taoqiuyang/SailBoat/Project Website/images/Portfolio/Tao.jpg

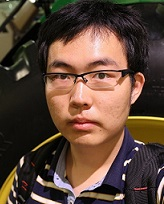
Project Website/images/Portfolio/Tao.jpg
