taoqiuyang/SailBoat/Project Website/images/Portfolio/Peng.jpg

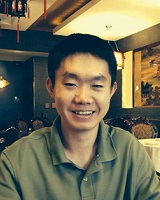
Project Website/images/Portfolio/Peng.jpg
