taoqiuyang/SailBoat/Document/Design/Requirements.docx

Requirements:

- Stay 30 days on ocean
- Autonomous control & navigation
- Multiple sensors

Two major parts:

- Energy harvest
- Control, navigation & actuation

Sensor and energy harvest options:

See Google Doc
