taoqiuyang/SailBoat/Document/Technical Review/Technical Review Xuefeng Jin.docx

Recharging Batteries for Autonomous Sailboat System

Introduction

Motivated mainly by latest energy sources such as the wave and the wind, autonomous sailboat system explores the viability of types of supply resource that are both economical and environmental-friendly. The electrical energy is the direct supply for motor and controller. Transforming other types of energy into electricity requires several storage elements that are highly efficient, environmental-friendly and lightweight. Chemical batteries, such as NiMH, Li-ion, and simple sea batteries, are the most appropriate choices for sailboat system. This technical review briefly summarizes some commercial and research battery choices for autonomous sailboat system, illustrates underlying technologies applied, and provides approaches of implementation for ideal operation.

Commercial and Research Choices of Batteries

The traditional Nickel-metal hydride (NiMH) and Lithium-ion (Li-ion) batteries are the most appropriate choices for the small sailboat system. Both of them are environmental-friendly and have no memory effect that refers to holding less charge after repeatedly recharging while being only partially discharged. They are perfect for storing energy supplied from the wind and the sun. Another type, broadly used in small projects for research, is the seawater battery that can store and transfer energy from seawater immediately. Therefore, it can be used to transform wave energy when the boat is moving.

NiMH Battery

Most small-sailboat teams used NiMH battery due to its simple implementation and low price [1-3]. It can be directly utilized through the connection, and has a voltage of 1.2 V, efficiency of 65-70%, typical specific energy of 60-120 Wh/kg, and a volumetric energy density of 140-200 Wh/L [4]. Panasonic “Eneloop” series battery can have a lifetime up to 2100 cycles [5]. The problem of high self-discharge was solved by Sanyo in 2005 with low self-discharge NiMH (LSD NiMH), and therefore it could be a competitor with Li-ion for boat system. Besides, the price has an advantage, typical 8-piece C-size NiMH rechargeable cell with 1.2 V and 5 Ah costs $30, while the 4-piece LiFePO4 with 3.6 V and 650 mAh costs $40 with protected circuit components [6-8].

Li-ion Battery

Li-ion battery is chosen due to stronger characteristics than those of NiMH. It has a voltage of 3.6-3.7 V, efficiency of 90-95%, specific energy of 100-265 Wh/kg, and higher energy density [9-11]. Among various types of Li-ion batteries, LiCoO2 has the highest energy density of more than 200 Wh/kg, and it is the most popular cell used in the market. However, it is unsafe without protection circuit (PC) and has a relatively low life cycles around 500. LiFePO4 is another type of Li-ion battery that has more than 2000 cycles of life, but it has relatively lower energy density of 120 Wh/kg [10]. The LiFePO4 cells are still in developing, and most of them are required to be industrial used only [12].

Seawater Battery

Some research teams have found seawater battery, which could draw electricity from seawater for free [13,14]. It is composed of magnesium as the anode, graphite as the cathode, and seawater as the electrolyte. The battery drives the output as long as it is in the sea. It has the simplest set-up, and provides constant propulsion for the boat. The cost is low for building one with basic connection. A one-foot magnesium anode with 0.5 inch diameter costs $4.03, and a one-foot graphite rod with 0.4 inch diameter costs $4 [15,16]. Thus, the seawater battery is the best approach for the sea-wave energy transformation.

Technology of basic batteries

Functionality

The basic recharging batteries transform the electrical to chemical energy during charging, and the process is reversed while discharging. During discharging, the positive active material is oxidized, while the negative material is reduced. Electrons constitute the current flow in external circuit, while the electrolyte serves as a bridge for ion-flow between electrodes. The process for both electrodes reverses while recharging.

Structure and Protection

In NiMH battery, the cathode is nickel oxyhydroxide (NiOOH), and the anode is a hydrogen-absorbing alloy such as TiZr and LaNi5 [17]. When the battery is overcharged at low rates, oxygen produced at the cathode recombines at the anode, suppressing hydrogen evolution and converting charging energy to heat. This process allows cells to remain sealed in normal operation. In Li-ion battery, the cathode is an intercalated lithium compound such as LiFePO4 or LiCoO2, and the anode is graphite for most cases. The electrolyte is a lithium salt in an organic solvent [18,19]. Since lithium is highly reactive with water, a non-aqueous electrolyte is applied. Therefore, it is significant to have an excellent sealed container that excludes moisture leaked by the battery for application in seawater. Particularly, the most concerned risk is that if over-charged, Li-ion battery will suffer thermal runaway and cell rupture that cause combustion, and therefore a protected circuit is required for disconnection when the voltage exceeds 3-4.2 V safety range [8,20]. The structure for seawater battery is the simplest. It is composed of magnesium alloy and graphite electrodes, while the electrolyte is the seawater.

Implementation

Due to the simplest setup and direct supply from seawater, seawater battery is an ideal choice for wave energy transformation. It can be directly connected to propeller for propulsion. The NiMH and LiFePO4 batteries are both ideal choices for transformation of other types of energy sources depend on the system requirements. NiMH battery can be directly utilized and can be over-charged at low rates. Li-ion battery requires a complex protected circuit board for safety consideration, which enhances the complexity of the design. The input of batteries is connected to the conditioning circuit that transforms renewable energy into stable electrical current and voltage. Typical conditioning circuit is composed of a converter, and its output should be applicable to battery other than super capacitor. The output goes to the motor and single-board computer that controls sensors for movements of the sailboat.

Reference

[1] SilverJimmy, “Making an autonomous boat using a Raspberry Pi (WiP),” Mar. 18, 2013. [Online].

Available: http://www.instructables.com/id/Making-an-autonomous-boat-with-a-Raspberry-Pi-a-/?

ALLSTEPS. [Accessed: Mar. 18, 2015].

[2] Aber’s Autonomous Sailing Robot, “Introducing the MaxiMOOP and our student Sailbot Team,” Jun.

08, 2013. [Online].

Available: https://microtransat.wordpress.com/. [Accessed: Mar. 18, 2015].

[3] Bluebird Marine Systems, “FishPi: An autonomous drop in the ocean.” [Online].

Available: http://www.bluebird-electric.net/artificial_intelligence_autonomous_robotics/

fishpi_raspberry_computer_autonomous_boat_marine_unmanned_surface_vessel_proof_of_

concept.htm. [Accessed: Mar. 18, 2015].

[4] PowerStream, “NiMH Battery Charging Basics,” Jan. 28, 2015. [Online]. Available:

http://www.powerstream.com/NiMH.htm. [Accessed: Mar. 18, 2015].

[5] Panasonic, “Eneloop series NiMH Products,” [Online]. Available:

http://panasonic.net/energy/battery/eneloop/lineup/. [Accessed: Mar. 18, 2015].

[6] AA Portable Power Corp, Pricing Information. Jun. 27, 2012. [Online]. Available:

http://www.batteryspace.com/csizeseriesbatteries.aspx.

[7] AA Portable Power Corp, Nickel-Metal Hydride Battery Specification Sheet. Jul. 7, 2009. [Online].

Available: http://www.batteryspace.com/prod-specs/MH-C5000_1.pdf.

[8] AA Portable Power Corp, “Category: PCB/PCM for 3.2 V LiFePO4 Pack (1S),” [Online].

Available: http://www.batteryspace.com/pcbfor32vlifepo4pack1inseries.aspx.

[Accessed: Mar. 20, 2015].

[9] Panasonic, Rechargeable Lithium-ion Battery CGR18650CG Specification Sheet. Dec. 2008.

[Online].

Available: http://web.archive.org/web/20100413182032/http://www.panasonic.com/industrial/

batteries-oem/oem/lithium-ion.aspx.

[10] AA Portable Power Corp, “Category: Li-Ion / Polymer Single Cells,” [Online].

Available: http://www.batteryspace.com/li-ionsinglecell.aspx. [Accessed: Mar. 20, 2015].

[11] C. Daniel, “Materials and Processing for Lithium-ion Battery,” JOM: Journal of the Minerals, Metals

and Materials Society, vol. 60, pp. 43-48, Sep. 2008.

[12] AA Portable Power Corp, “Category: CR123A Rechargeable LiFePO4/Li-ion Batteries,” [Online].

Available: http://www.batteryspace.com/rcr123aseries.aspx. [Accessed: Mar. 22, 2015].

[13] Free Electricity From Sea Water. [Video file]. Youtube, Nov. 7, 2014.

Available: https://www.youtube.com/watch?v=BsW3oQFdg6M&feature=youtu.be.

[Accessed: Mar. 20, 2015.].

[14] Electric Boat without Batteries. [Video file]. Youtube, Dec. 5, 2014.

Available: https://www.youtube.com/watch?v=U0OAaW4En7o&feature=youtu.be.

[Accessed: Mar. 20, 2015.].

[15] RotoMetals, Pricing Information. [Online]. Available:

http://www.rotometals.com/Magnesium-Anodes-s/22.htm. [Accessed: Mar. 22, 2015].

[16] Ebay, Pricing Information. [Online]. Available:

http://www.ebay.com/itm/5-pcs-99-99-Graphite-Electrode-Cylinder-Rod-Length-100mm-

Diameter-10mm-EV-28-/171398820297?pt=LH_DefaultDomain_0&hash=item27e82a71c9.

[Accessed: Mar. 23, 2015].

[17] R. F. Koontz and D. R. Lucero, “Magnesium Water-Activated Batteries,” 2002. [Online].

Available: http://chemecar.wikispaces.asu.edu/file/view/water-activated%20battery.pdf.

[Accessed: Mar. 21, 2015].

[18] J. C. Kopera, "Inside the Nickel Metal Hydride Battery,” Jun. 25, 2004. [Online].

Available: http://www.cobasys.com/pdf/tutorial/inside_nimh_battery_technology.pdf.

[Accessed: Mar. 21, 2015].

[19] M. Silberberg, Chemistry: The Molecular Nature of Matter and Change, 4th Ed. New York:

McGraw-Hill Education, 2006, pp. 935.

[20] M. M. Thackeray, J. O. Thomas and S. M. Whittingham, “Science and Applications of Mixed

Conductors for Lithium Batteries,” MRS Bulletin, vol. 25, iss. 3, pp. 39-46, Jan. 2011.

ECE 4011 - Culminating Design Project Autonomous Sailboat System
