taoqiuyang/SailBoat/Document/Design/Functional Diagram.pdf

## Optional

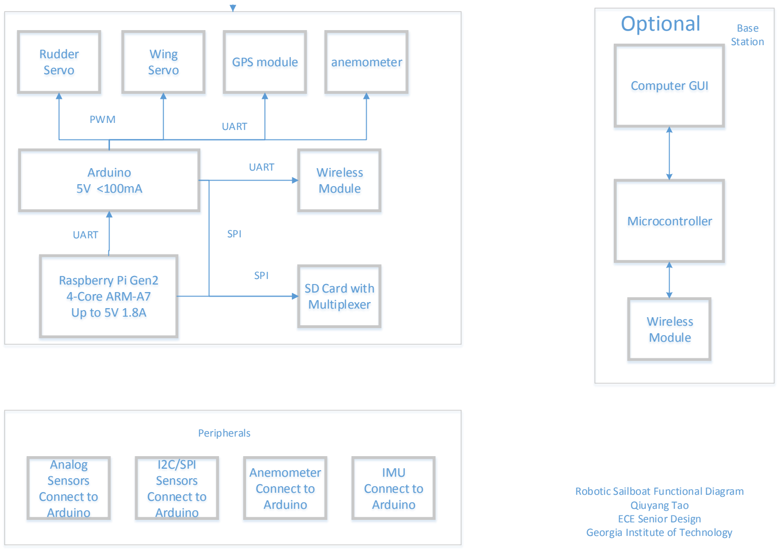
[picture p15: page 1]

Computer GUI

Microcontroller

Wireless
Module

Rudder
Servo

Wing
Servo

Raspberry Pi Gen2
4-Core ARM-A7
Up to 5V 1.8A

Analog
Sensors
Connect to
Arduino

I2C/SPI
Sensors
Connect to
Arduino

IMU
Connect to
Arduino

Anemometer
Connect to
Arduino

Base
Station

Robotic Sailboat Functional Diagram Qiuyang Tao
ECE Senior Design
Georgia Institute of Technology

GPS module

PWM | | UART
Arduino 5V <100mA | UART | Wireless Module

UART

SD Card with
Multiplexer

SPI

Peripherals

SPI

anemometer
