taoqiuyang/SailBoat/Document/Design/Power system.pdf

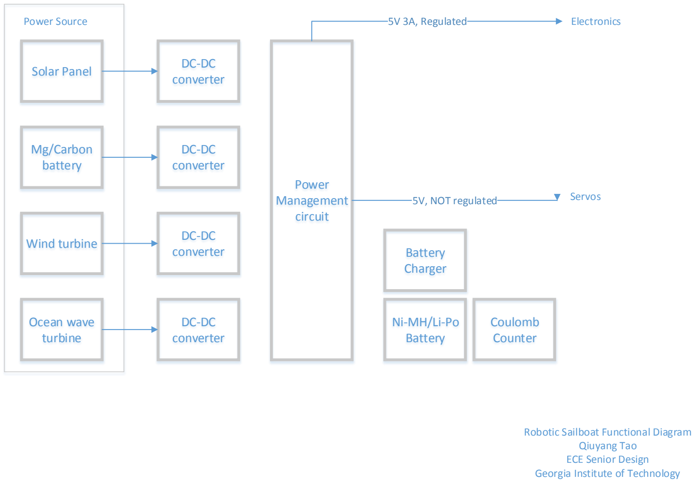
[picture p16: page 1]

Solar Panel | DC-DC converter

### Mg/Carbon battery

### Wind turbine

### Ocean wave turbine

Power Source

### DC-DC converter

DC-DC
converter

### DC-DC converter

### Power Management circuit

Battery
Charger

### Ni-MH/Li-Po Battery

### Coulomb Counter

5V 3A, Regulated

5V, NOT regulated

Electronics

Servos

Robotic Sailboat Functional Diagram Qiuyang Tao
ECE Senior Design
Georgia Institute of Technology
