taoqiuyang/SailBoat/Document/Project Summary/Final Project Summary.pdf

## ECE4011/ECE 4012 Project Summary

Project Title | Autonomous Sailboat for Penguins Tracking
Team Members (names and majors) | Ci Chen, EE Enmao Diao, EE/CS Xuefeng Jin, EE Qiuyang Tao, EE Yuqing Peng, CompE
Advisor / Section | Prof. Michael West / L4B
Semester | 2015/Fall (ECE4012)

Project Abstract
(250-300 words) | The Sailboat for Penguins Detecting and Recording is one kind of unmanned
| surface vehicles (USV) which is designed to provide an effective ocean
| sampling capability. Current commercial products are too expensive and
| cannot achieve the best engineering tradeoffs because energy management
| prevents such USV from maintaining high speed and long operation duration
| simultaneously. Our design combines a hybrid energy supply system and
| opensource electronic prototyping platforms to gather and transmit data. It
| utilizes the Global Positioning System (GPS) and the long range wireless
| communication for navigation (for prototype shortrange modules were
| applied due to limited budget).
| The sailboat system has better energy management system and is marketed to
| detect the penguins and track them near their habitats. Additional energy
| resources and power efficient prototyping platforms make it possible. Better
| energy management leads to a higher speed and a longer operation duration.
| The long range wireless communication module enables real time data
| transmission and manual control.
| Current commercial products aim to be implemented in the research area, and
| therefore are sold at a very high price. By lowering the prices, our device can
| be accepted by general research and protection of the penguins. Replacing
| normal sensors for research such as thermometers and anemometers with GPS
| tracking and cameras, scientists and environmentalists are able to utilize this
| product to track and analyze the penguins habits. At the beginning stage of the
| design, the team applied an appropriate sailboat kit. Sensors and modules such
| as IMU and GPS were implemented to the sailboat. By the end of the
| development stage, the team designed one complete builtup prototype which
| includes energy supply system, cameras recording functions and GUI control.
| The device has been tested on the lake in Piedmont Park to demonstrate the
| speed, operation duration, and data sampling functions.

Project Title | Autonomous Sailboat for Penguins Tracking

### List codesand standardsthat significantly affect your project. Briefly describe how they influenced your

design.

| 1). SPI, Serial Peripheral Interface. Synchronous serial interface which connects relatively higher speed sensors and MultiMediaCard/Secure Digital (MMC/SD) card. 2). UART, Universal Asynchronous Receiver/Transmitter. Socalled serial port, a very easy way to utilize popular industrial communication device, including simple baud generator, transmitter and receiver. 3). IEEE 802.15.4. Basis of Zigbee. The telemetry protocol we will use for digital data communication. 4). USB, Universal Serial Bus. In the project, we will use USB to connect High definition (HD) camera and other highspeed peripherals. 5). TTL, Transistor–Transistor Logic. Logic 0 is defined between 0V to 0.8V and logic 1 has range from 2.2V to 5V (Vcc). This standard will be used in our digital circuit design. 6). SD, Secure Digital. The type of nonvolatile memory card we will use to store sensor data and system logs.

### List at least two significant realistic design constraints that applied to your project. Briefly describe how they

affected your design.

| 1). Energy Consumption. The application requires the sailboat to cruise on ocean for a couple of months. Since the energy from the environment is limited, power management is required to reduce the consumption of the energy.
| 2). Limited Budget. The total budget is $1000 so highend or professional products are out of the budget. Inexpensive, onshelf, and proven components are needed for the project.
| 3). Accuracy of Sensors. Civilian GPS modules have 10-meter accuracy, and mainstream MEMS Gyroscopes drifts with time.
| 4). Limitation of Actuators. On shelf servos have limited precision, speed and torque. For example, Turnigy 1370A has speed of 0.1sec/60º and torque of 0.4kg/cm.
| 5). Extreme Cases. Extreme cases like nowind operation need to be considered, since the sailboat highly depends on wind energy.
| 6). Limited Size. Limited size of the boat constraints the possibility to install higher power energy harvesting devices. For instance, limited area of the sail and the solar panel can be mounted on the sailboat, and therefore the maximum harvested power is limited.

### Briefly explain two significant tradeoffs considered in your design, including options considered and

the solution chosen.

| 1). Battery Life vs. Selfdischarge Rate. Use rechargeable batteries instead of super capacitors. The rechargeable battery providess a more stable output voltage, and has much lower selfdischarge than super capacitor does. Although super capacitor has almost an unlimited life cycle and shorter charging and recharging periods, it can not store energy for long time and is not suitable for the seawater environment.
| 2). Computational Performance vs. Energy Consumption. Use ARM mbed to handle sensor data collecting and navigation, and use Raspberry Pi only for Digital Signal Processing (DSP) algorithms. Performance was limited when using mbed but it consumed much less energy.
| 3). Navigation Accuracy vs. Cost. Differential GPS and highergrade inertia sensing components can provide better navigation but the cost will blow up.

Compromise was made to use conventional GPS module and mainstream Micro-Electro-Mechanical System (MEMS) Inertial Measurement Units (IMUs). Inexpensive gyroscopes drift a lot. As a result, accelerator and digital compass were required to compensate the error. Also, even with a cheap, conventional GPS module, better antenna along with Lownoise amplifier (LNA) could increase the number of satellites from which we received signals.

4). Actuator Performance vs. Cost. Use onshelf RC servos instead of professional system including stepper motor, gearbox and shaft encoder system. By doing this, we do not need to worry about the feedback control of the actuators, all we need to do was to send the desired angle to the servos. This tradeoff significantly reduced complicity of the system even though it is less accurate and efficient.

5). Wireless Communication Performance vs. Cost. Most of the satellite data communication transceivers are beyond budget. So we are using alternate solution instead of satellite to reduce cost. However, this tradeoff greatly limits the range. Most satellite system such as Iridium can provide global access, but the range of our alternate solution is limited by transmitting power, receiver sensitivity and operating environment.

### Briefly describe the computing aspectsof

your projects,

### specifically identifying hardwaresoftware

tradeoffs, interfaces,
and/or interactions.

### Complete if applicable; required if team includes CmpE

majors.

For the energy source of the boat, the team used solar energy. Because of that, the power consumption of onboard electronics will be strictly limited, so the team decided to use ARM mbed as a lowpower platform for processing and navigation.

The inputs of the system are:
1. The destination longitude and latitude received via wireless module.
2. Location information from GPS module for navigation purpose.

The outputs of the system are:
1. Pulse Width Modulation (PWM) actuator command signal computer by mbed for wing and rudder servos. This signal is used to drive the sailboat to desired destination.
2. Sensor data processed by SBC could be sent to base station via wireless communication device.
