taoqiuyang/SailBoat/Document/Design/Hardware_connection.jpg

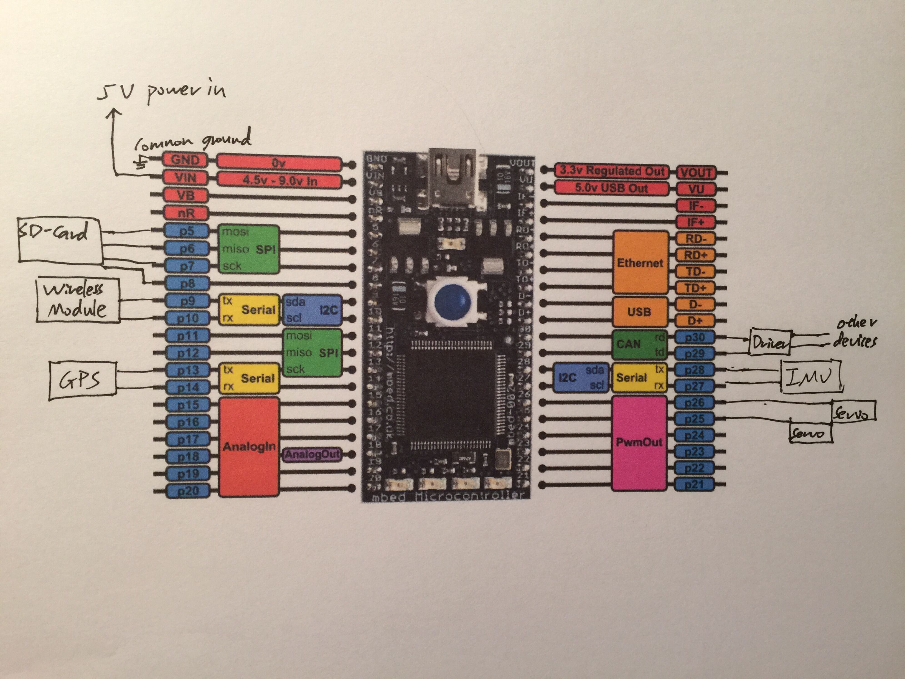
Document/Design/Hardware_connection.jpg
