taoqiuyang/SailBoat/Document/Oral Presentation/Weekly Log Template/template_internal2.jpg

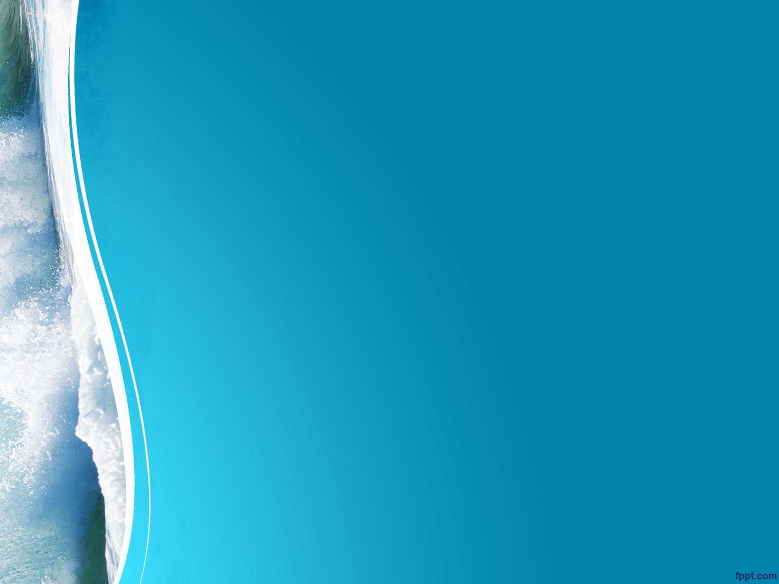
Document/Oral Presentation/Weekly Log Template/template_internal2.jpg
