taoqiuyang/SailBoat/Document/Oral Presentation/Weekly Log Template/template_internal.jpg

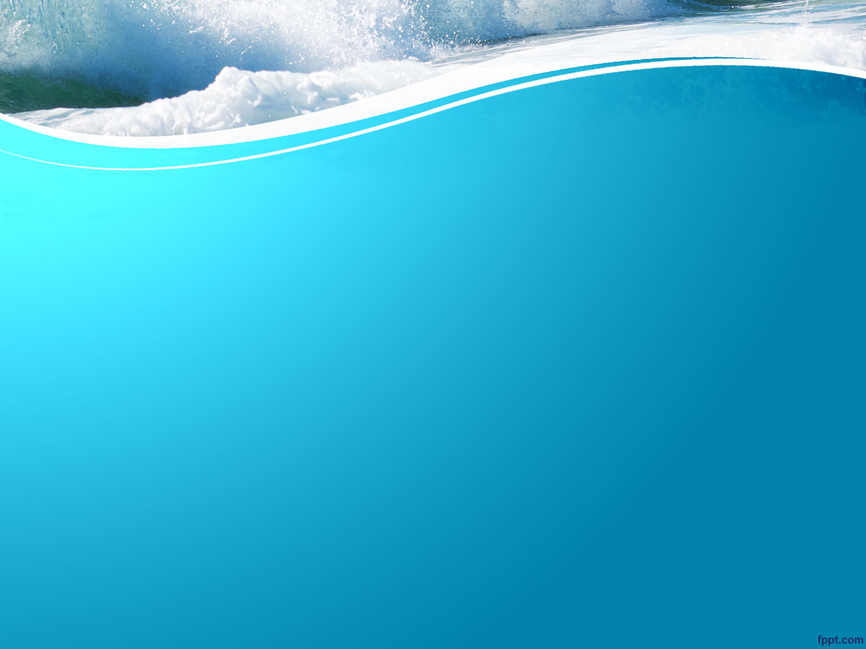
Document/Oral Presentation/Weekly Log Template/template_internal.jpg
