taoqiuyang/SailBoat/Document/Oral Presentation/Weekly Log Template/template_main.jpg

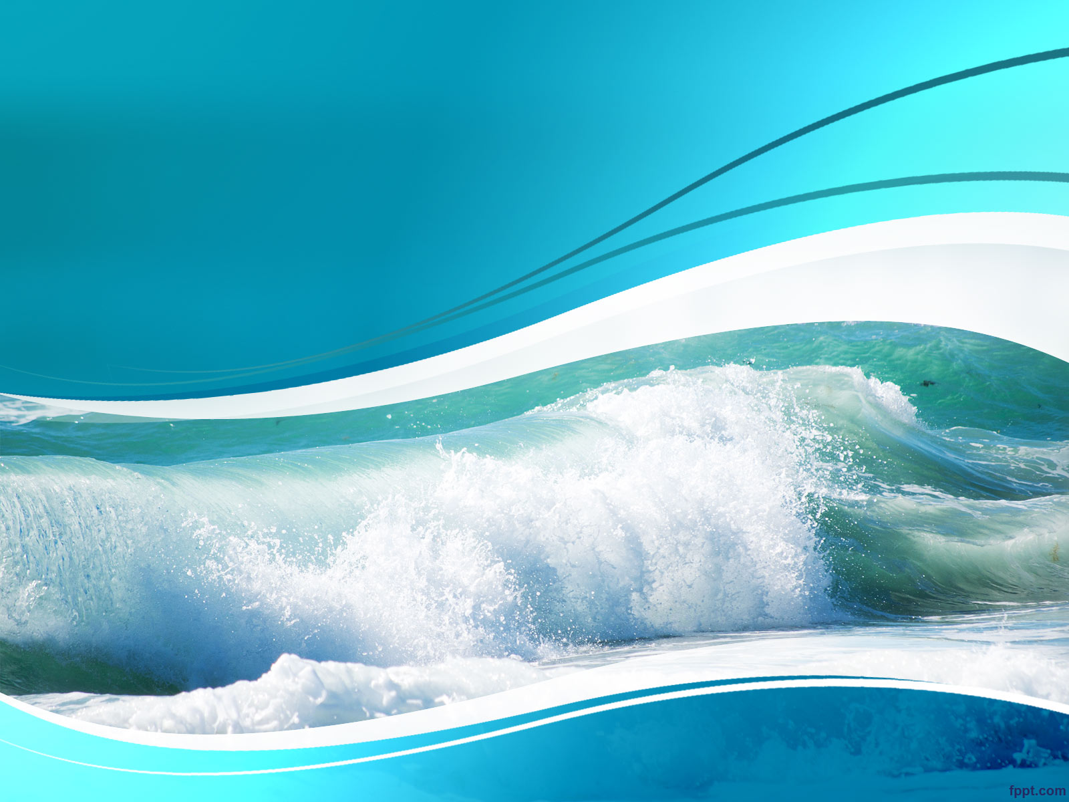
Document/Oral Presentation/Weekly Log Template/template_main.jpg
