taoqiuyang/SailBoat/Document/Reference/gps_pin.jpg

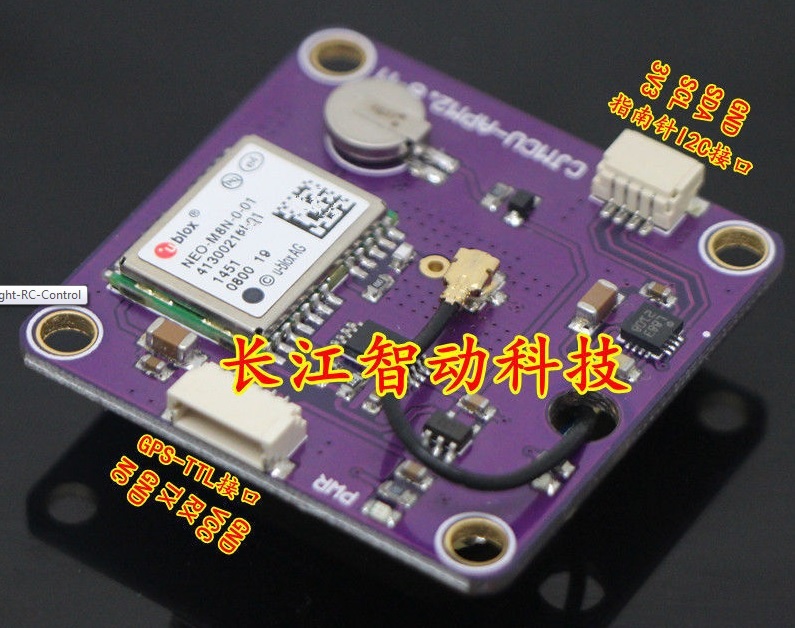
Document/Reference/gps_pin.jpg
