taoqiuyang/SailBoat/Mechanical Models/Functional Diagram-new.JPG

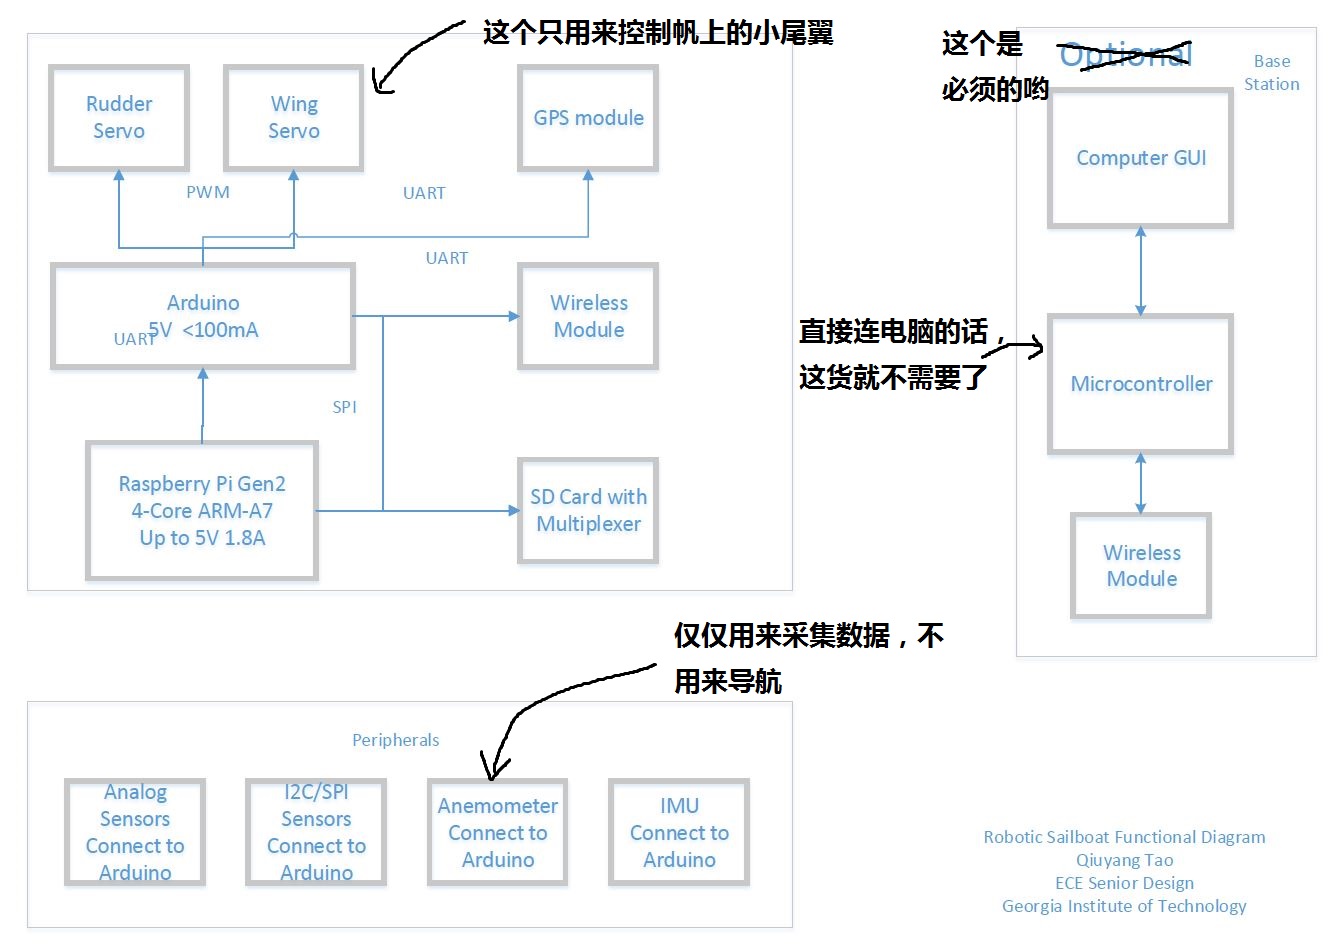
Mechanical Models/Functional Diagram-new.JPG
