taoqiuyang/SailBoat/Mechanical Models/sail_holder_1.JPG

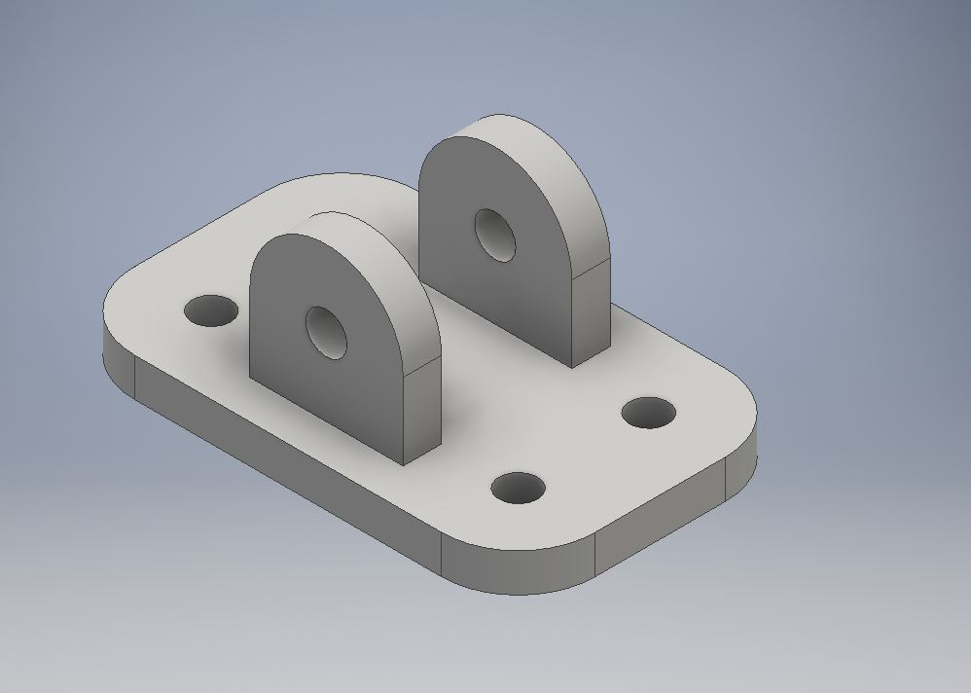
Mechanical Models/sail_holder_1.JPG
