taoqiuyang/SailBoat/Mechanical Models/sail_holder_2.JPG

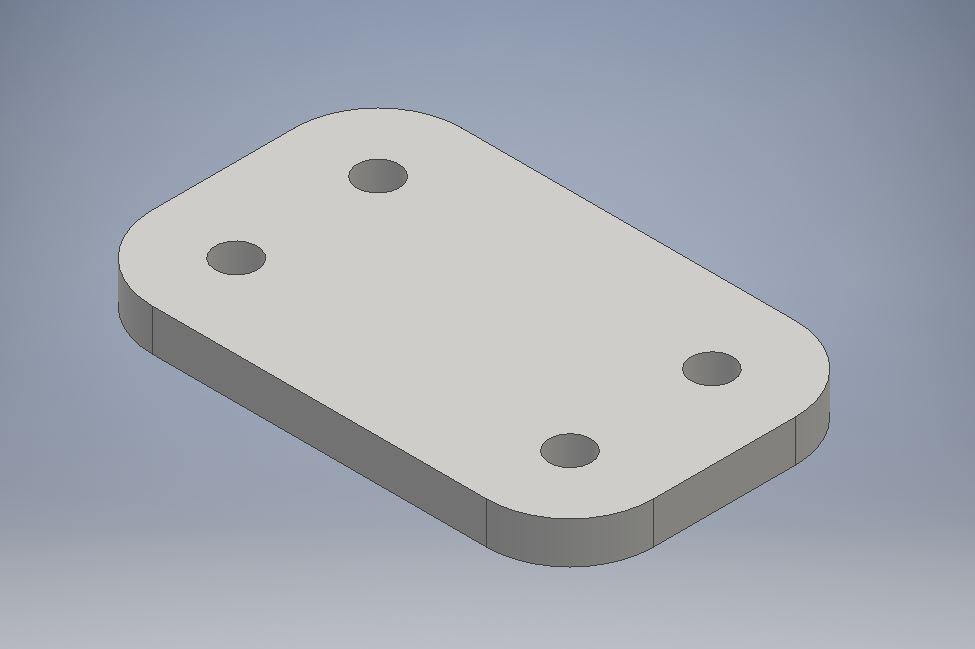
Mechanical Models/sail_holder_2.JPG
