taoqiuyang/SailBoat/Mechanical Models/sail_holder_2_1.JPG

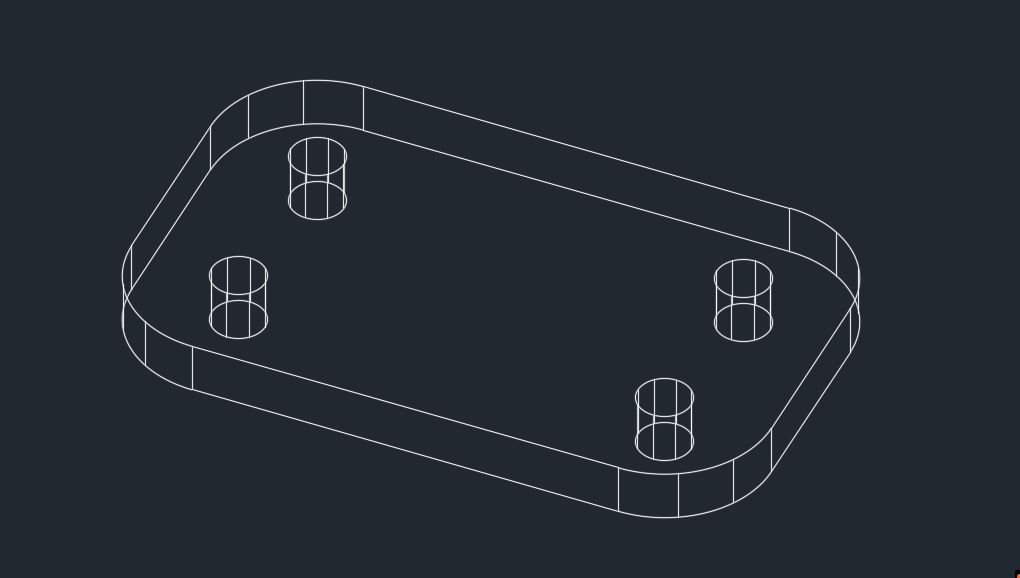
Mechanical Models/sail_holder_2_1.JPG
