taoqiuyang/SailBoat/Mechanical Models/wing_sail_base_1.JPG

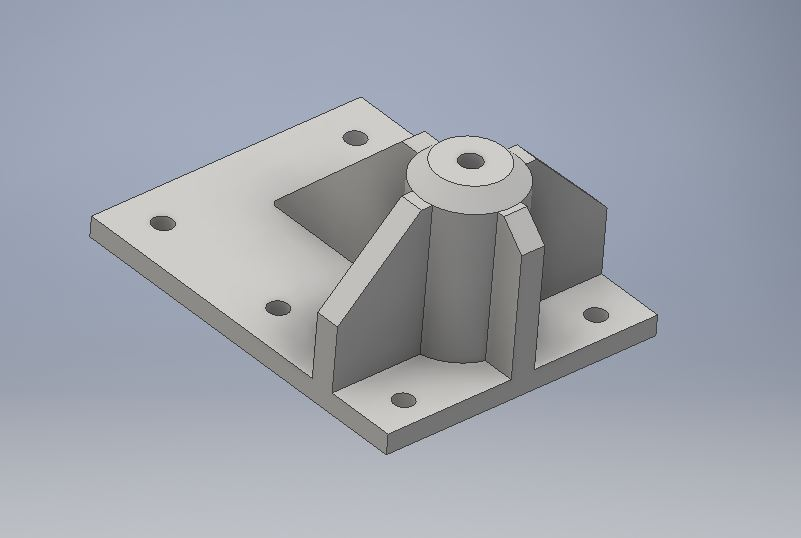
Mechanical Models/wing_sail_base_1.JPG
