taoqiuyang/SailBoat/Mechanical Models/wing_sail_base_CAD.JPG

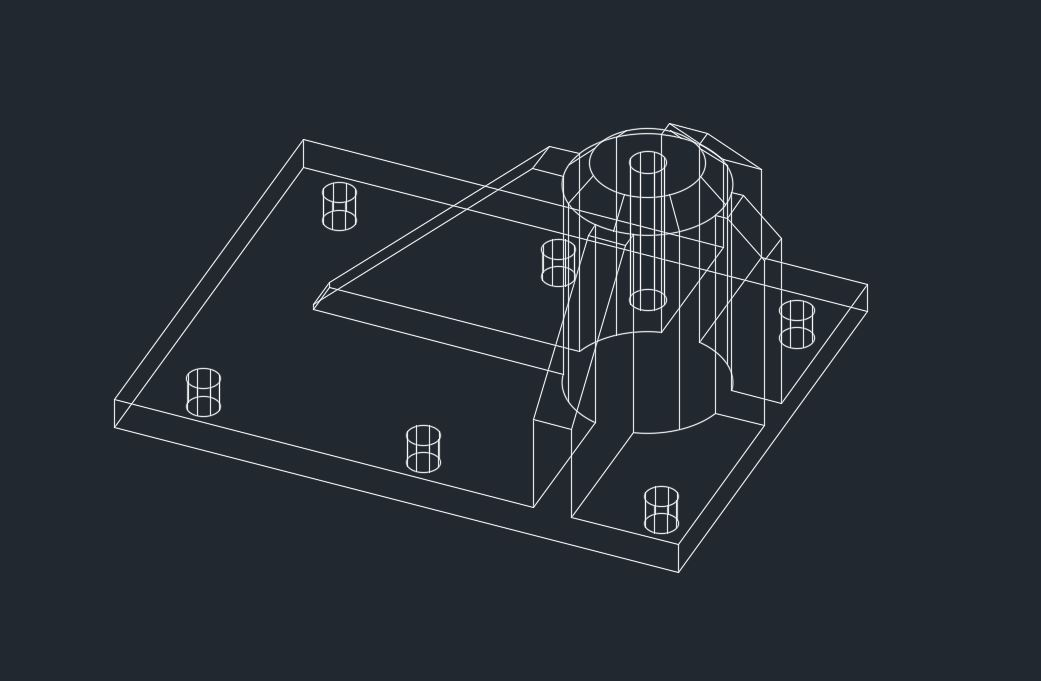
Mechanical Models/wing_sail_base_CAD.JPG
