taoqiuyang/SailBoat/Mechanical Models/wing_sail_base_front.JPG

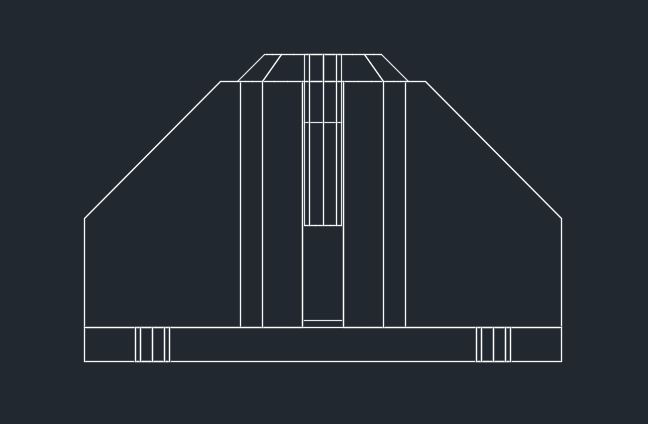
Mechanical Models/wing_sail_base_front.JPG
