taoqiuyang/SailBoat/Mechanical Models/wing_sail_base_side.JPG

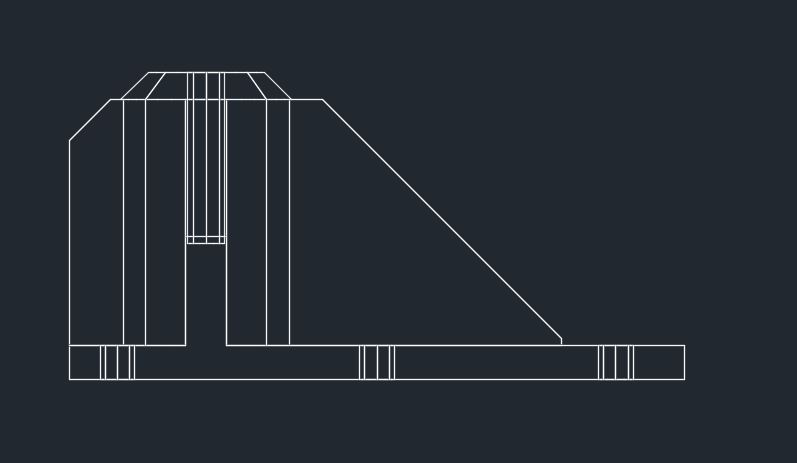
Mechanical Models/wing_sail_base_side.JPG
