taoqiuyang/SailBoat/Mechanical Models/wing_sail_base_top.JPG

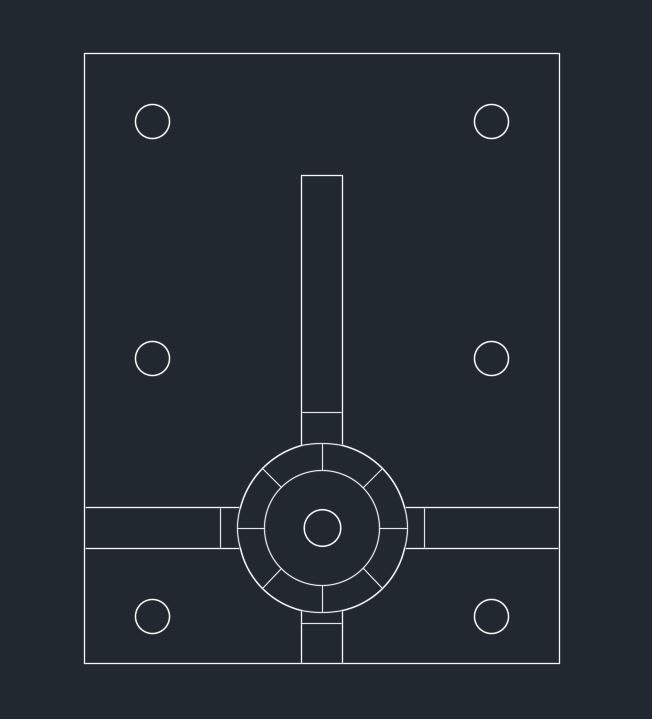
Mechanical Models/wing_sail_base_top.JPG
