taoqiuyang/SailBoat/Project Website/images/mbed.jpg

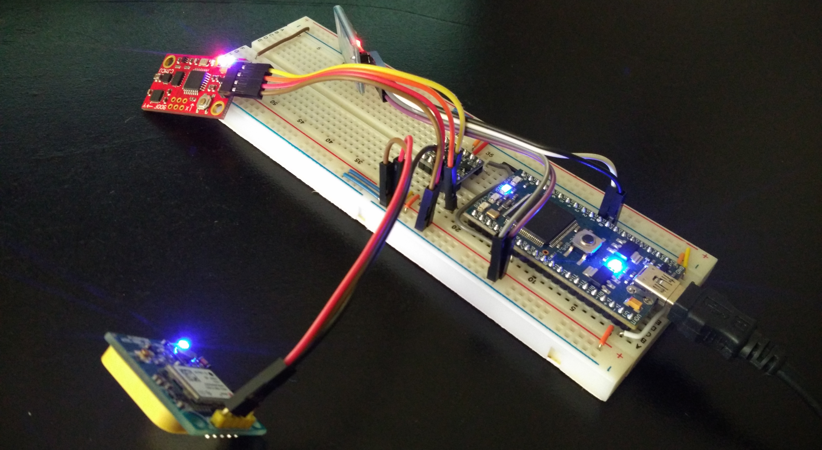
Project Website/images/mbed.jpg
