taoqiuyang/SailBoat/Project Website/images/pic01.jpg

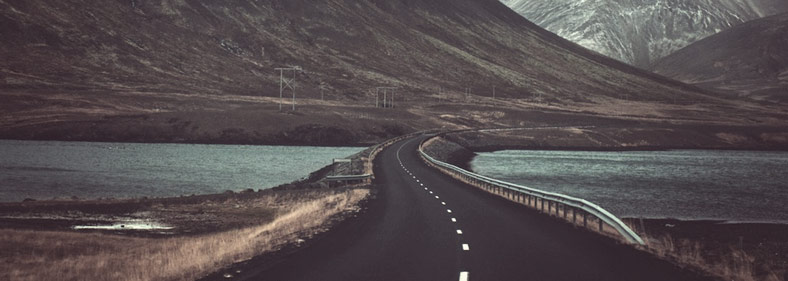
Project Website/images/pic01.jpg
