taoqiuyang/SailBoat/Project Website/images/pic02.jpg

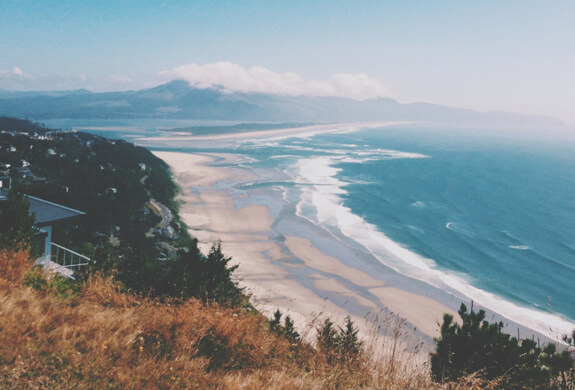
Project Website/images/pic02.jpg
