taoqiuyang/SailBoat/Project Website/images/pic03.jpg

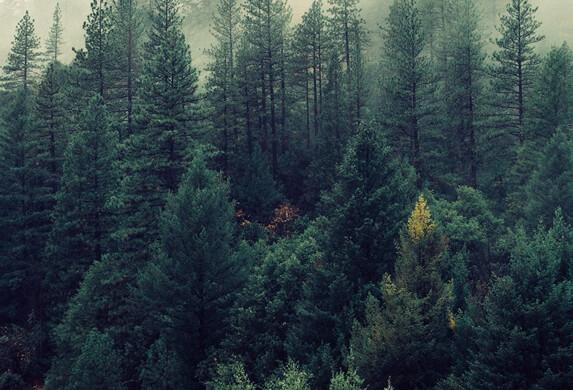
Project Website/images/pic03.jpg
