taoqiuyang/SailBoat/Project Website/images/pic04.jpg

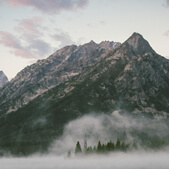
Project Website/images/pic04.jpg
