taoqiuyang/SailBoat/Project Website/images/pic05.jpg

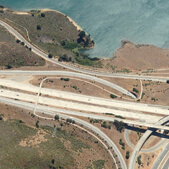
Project Website/images/pic05.jpg
