taoqiuyang/SailBoat/Project Website/images/pic06.jpg

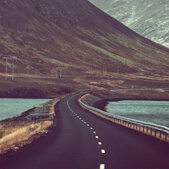
Project Website/images/pic06.jpg
