taoqiuyang/SailBoat/Project Website/images/pic07.jpg

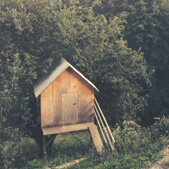
Project Website/images/pic07.jpg
