taoqiuyang/SailBoat/Project Website/images/Portfolio/Chen.jpg

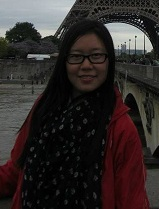
Project Website/images/Portfolio/Chen.jpg
