taoqiuyang/SailBoat/Project Website/images/Portfolio/Diao.jpg

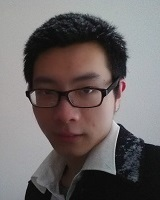
Project Website/images/Portfolio/Diao.jpg
