taoqiuyang/SailBoat/Project Website/images/Portfolio/Jin2.png

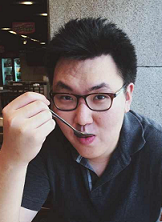
Project Website/images/Portfolio/Jin2.png
