taoqiuyang/SailBoat/Project Website/images/Portfolio/Jin.png

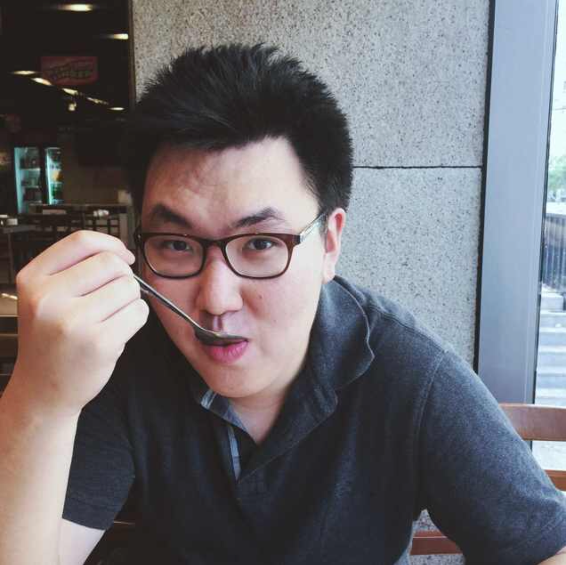
Project Website/images/Portfolio/Jin.png
