taoqiuyang/SailBoat/Project Website/images/Portfolio/West.jpg

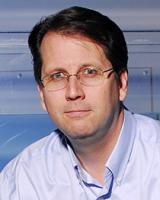
Project Website/images/Portfolio/West.jpg
