taoqiuyang/SailBoat/Project Website/images/us/pic01.jpg

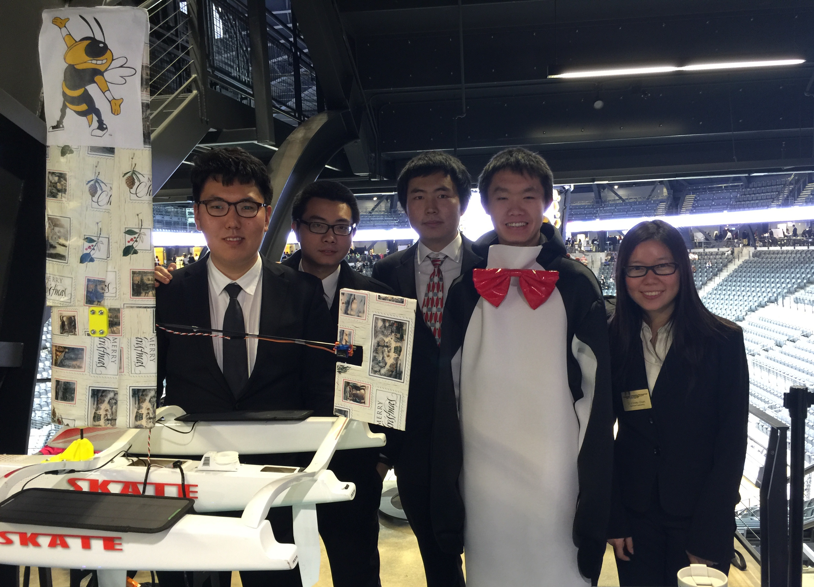
Project Website/images/us/pic01.jpg
