taoqiuyang/SailBoat/Project Website/images/us/pic02.jpg

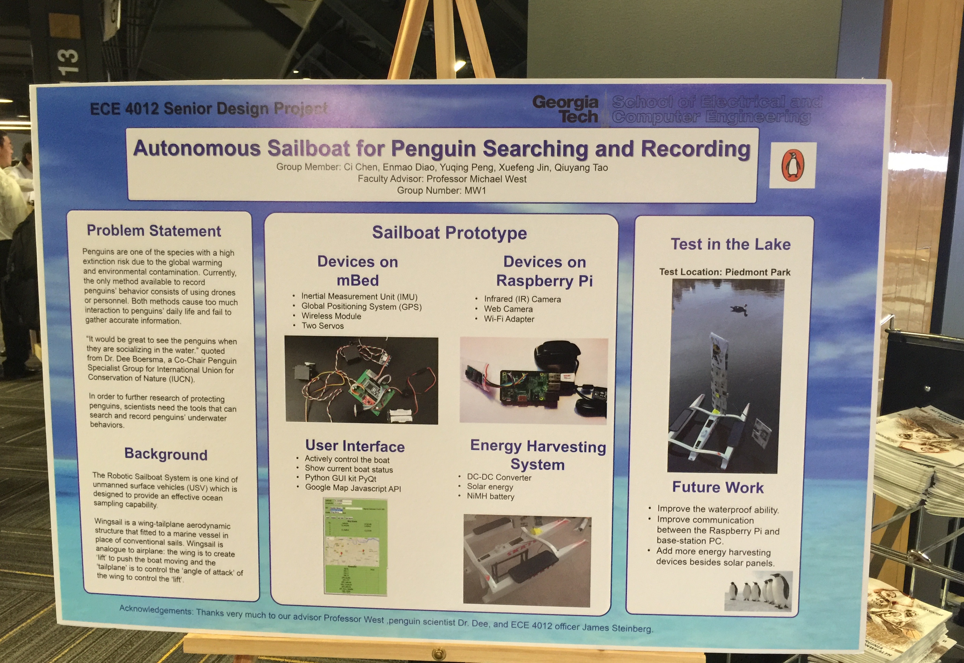
Project Website/images/us/pic02.jpg
