taoqiuyang/SailBoat/Project Website/images/us/pic03.jpg

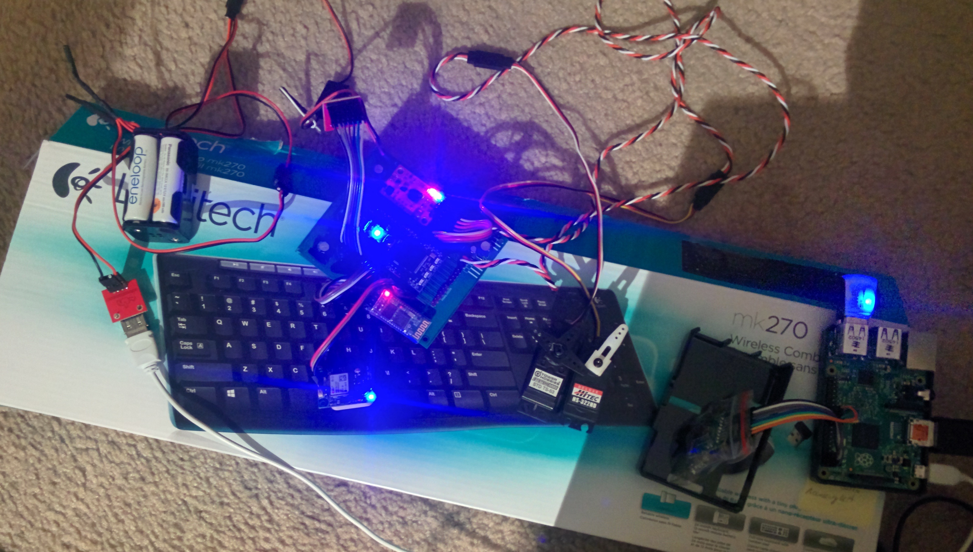
Project Website/images/us/pic03.jpg
