taoqiuyang/SailBoat/Project Website/images/us/pic04.jpg

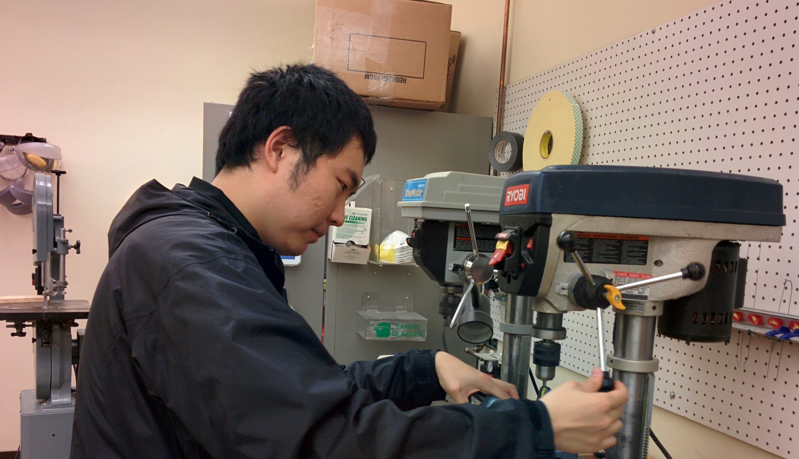
Project Website/images/us/pic04.jpg
