taoqiuyang/SailBoat/Project Website/images/us/pic05.jpg

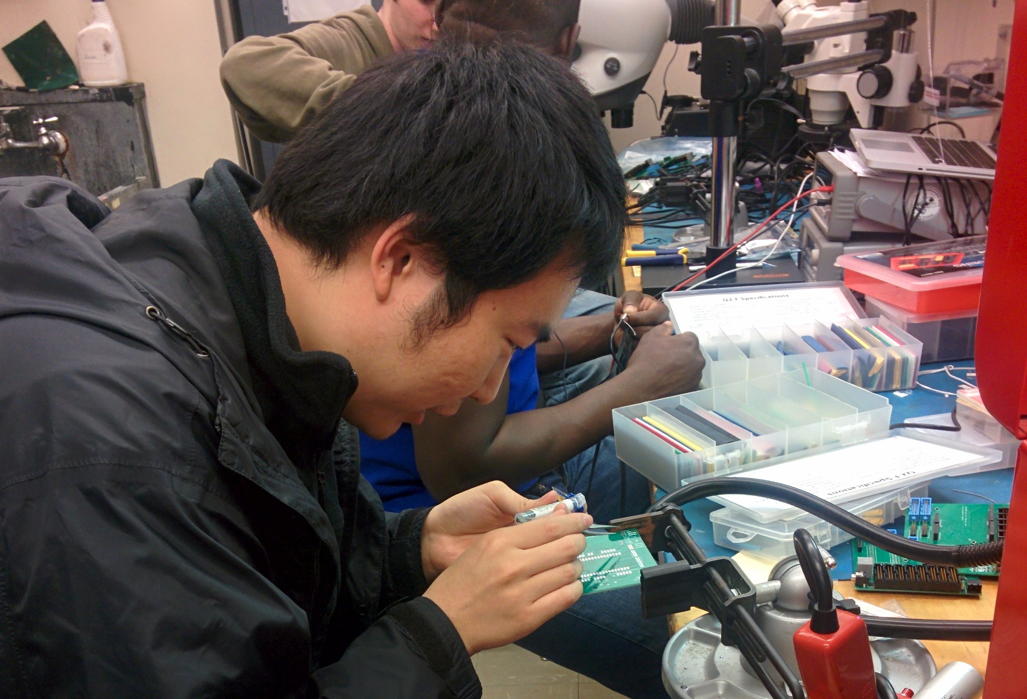
Project Website/images/us/pic05.jpg
