taoqiuyang/SailBoat/Project Website/images/us/pic06.jpg

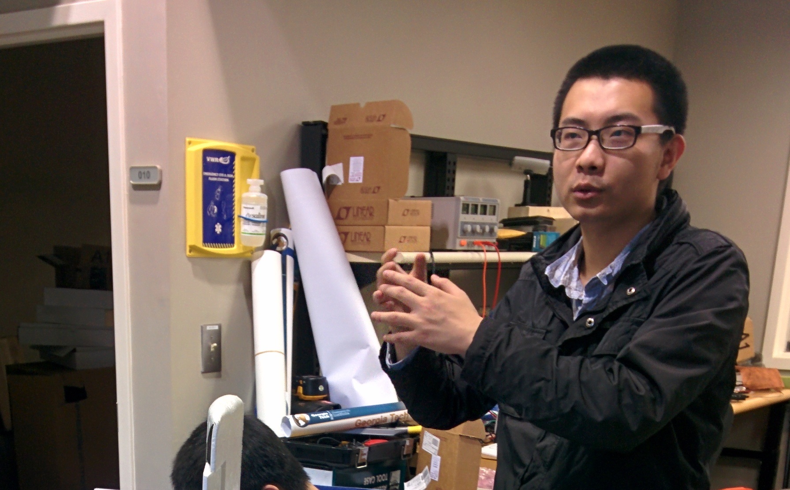
Project Website/images/us/pic06.jpg
