taoqiuyang/SailBoat/Project Website/images/us/pic07.jpg

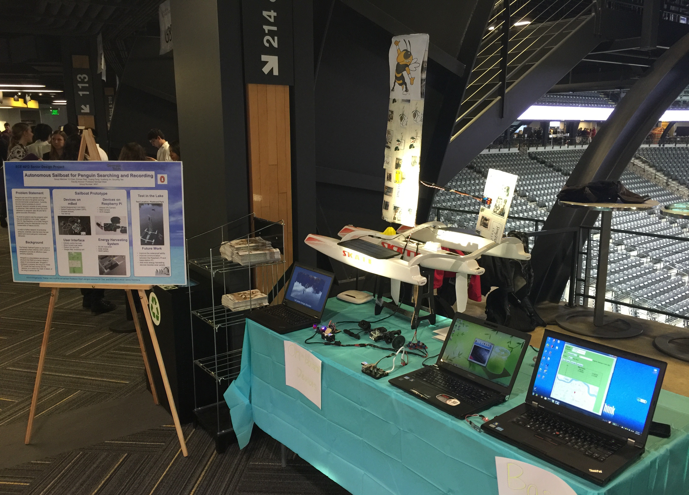
Project Website/images/us/pic07.jpg
