taoqiuyang/SailBoat/Project Website/images/us/pic08.jpg

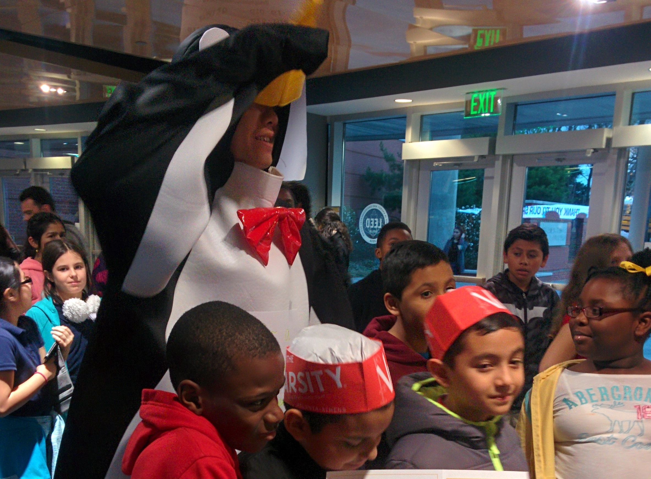
Project Website/images/us/pic08.jpg
