taoqiuyang/SailBoat/Mechanical Models/imu_case_2.stl

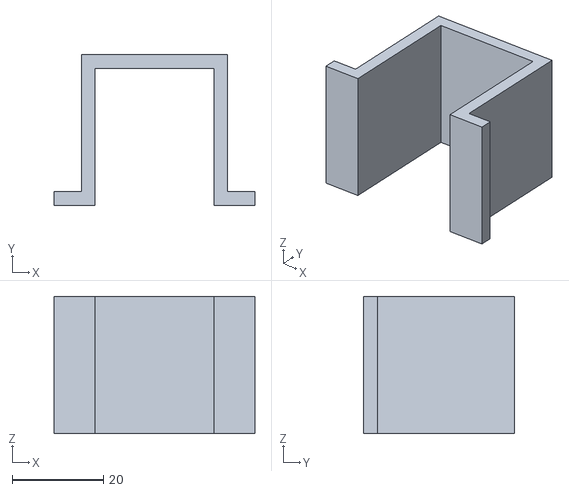
[picture p53: CAD file, 2015-11-16]
Mechanical Models/imu_case_2.stl
44.0 x 33.0 x 30.0
