taoqiuyang/SailBoat/Mechanical Models/imu_case_1.stl

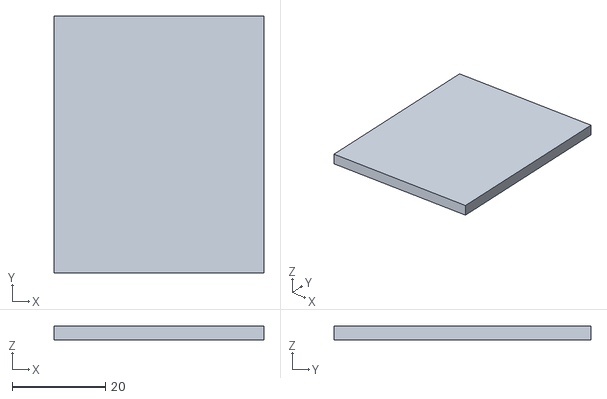
[picture p54: CAD file, 2015-11-16]
Mechanical Models/imu_case_1.stl
45.0 x 55.0 x 3.00
