taoqiuyang/SailBoat/Mechanical Models/rudder_hold_1.stl

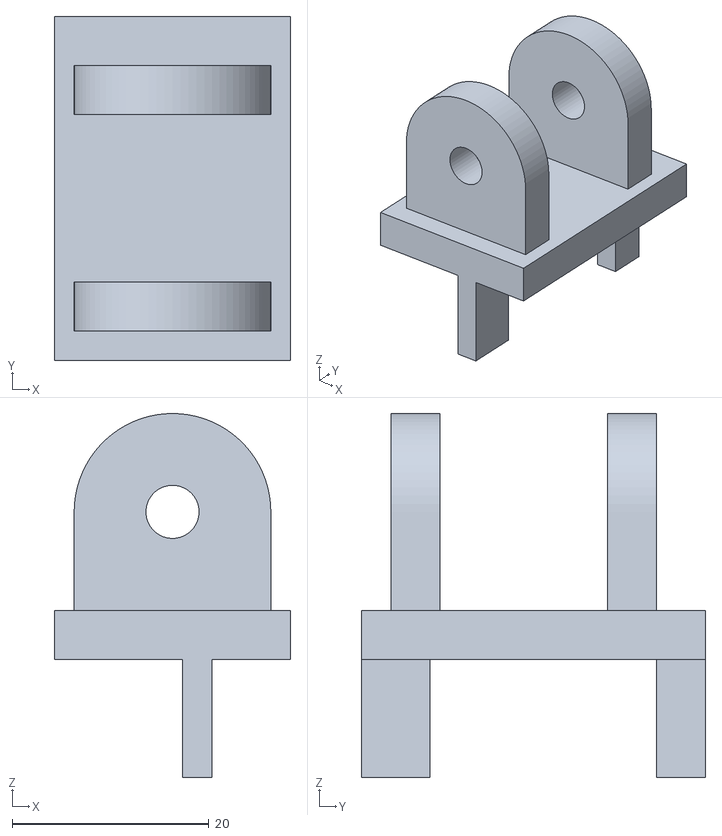
[picture p55: CAD file, 2015-11-04]
Mechanical Models/rudder_hold_1.stl
24.0 x 35.0 x 37.0
