taoqiuyang/SailBoat/Mechanical Models/wing_sail_base_1.stl

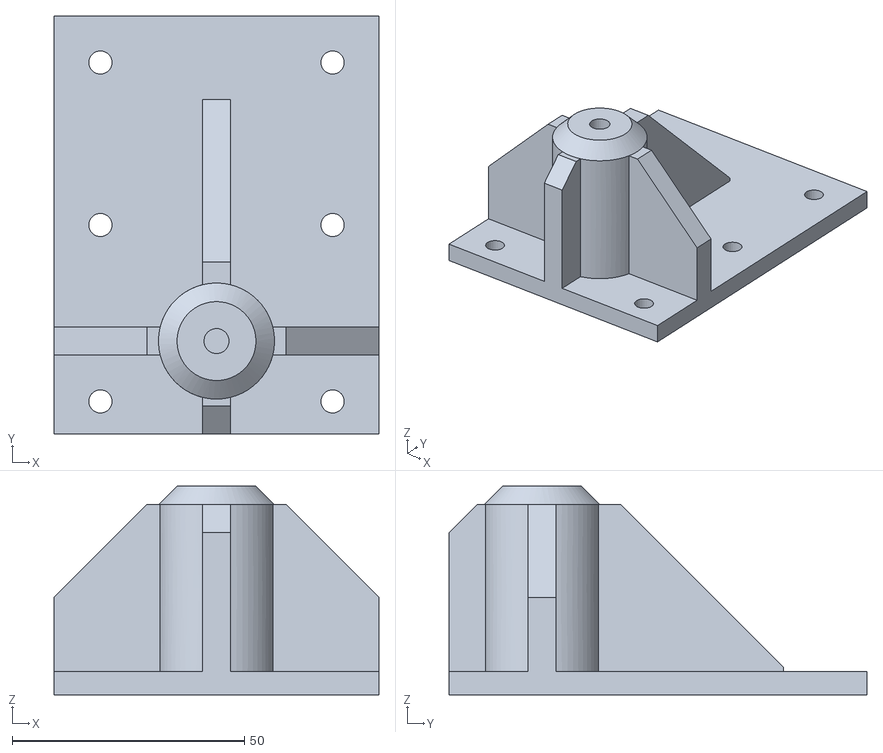
[picture p56: CAD file, 2015-11-01]
Mechanical Models/wing_sail_base_1.stl
70.0 x 90.0 x 45.0
