taoqiuyang/SailBoat/Mechanical Models/sail_hold_2.stl

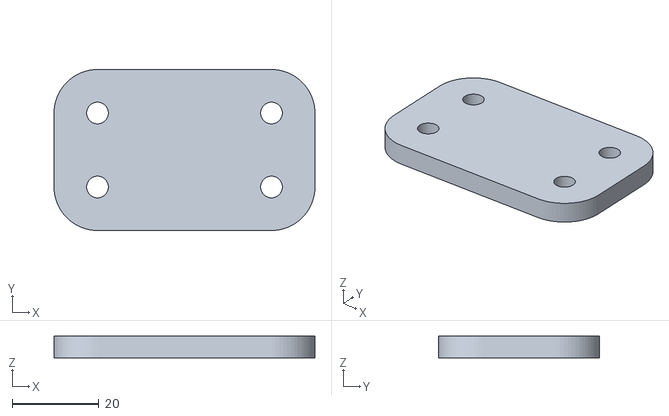
[picture p57: CAD file, 2015-11-01]
Mechanical Models/sail_hold_2.stl
60.0 x 37.0 x 5.00
