taoqiuyang/SailBoat/Mechanical Models/sail_hold_1.stl

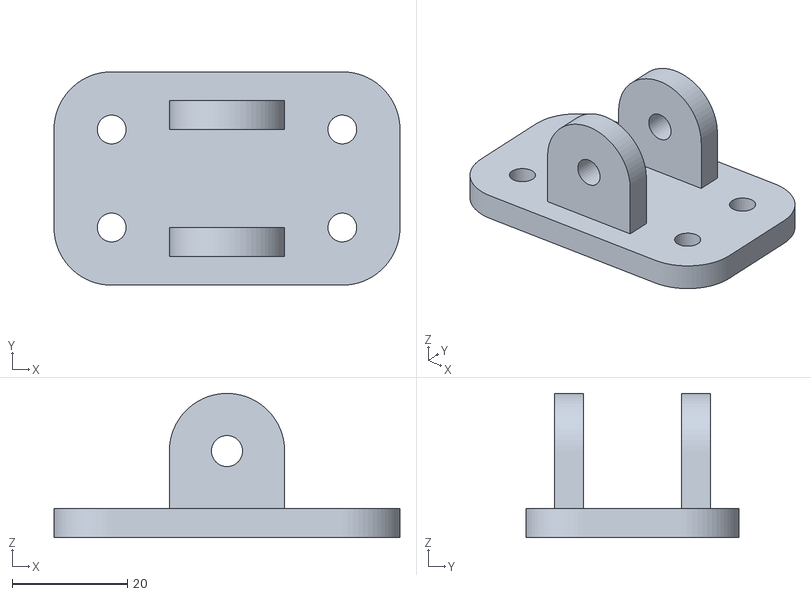
[picture p58: CAD file, 2015-11-01]
Mechanical Models/sail_hold_1.stl
60.0 x 37.0 x 25.0
