taoqiuyang/SailBoat/(list of files, cad)

Other CAD files:
Mechanical Models/OldVersions/imu_case_2.0001.ipt
Mechanical Models/OldVersions/rudder_hold_1.0001.ipt
Mechanical Models/carbon_fiber.ipt
Mechanical Models/imu_case_1.ipt
Mechanical Models/imu_case_2.ipt
Mechanical Models/rudder_hold.ipt
Mechanical Models/rudder_hold_1.ipt
Mechanical Models/sail_hold_1.dwg
Mechanical Models/sail_hold_1.ipt
Mechanical Models/sail_hold_2.dwg
Mechanical Models/sail_hold_2.ipt
Mechanical Models/sail_hold_assembly.iam
Mechanical Models/wing_sail_base_1.dwg
Mechanical Models/wing_sail_base_1.ipt
