taoqiuyang/SailBoat/Document/Arduino/Brief Arduino Tutorial.docx

Quick start guide for Robotic Sailboat navigation hardware platform

All the navigation and sensor data will be handled by Arduino

Raspberry Pi ONLY do heavy computational jobs to save power

PART 1. Core system using Arduino

1. Download Arduino IDE
a. Go to Arduino.cc and click download tag

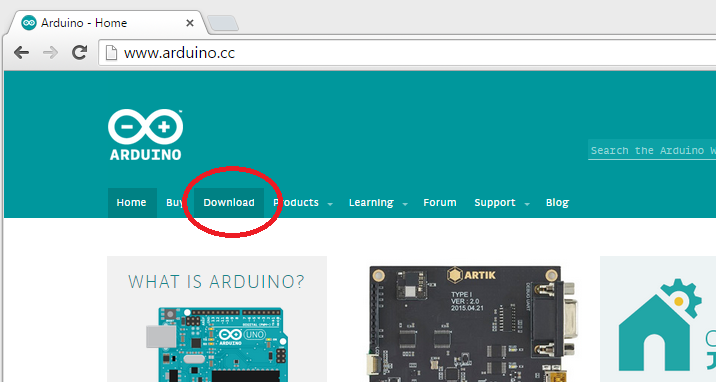
[picture p59: figure]

b. Choose your desired version

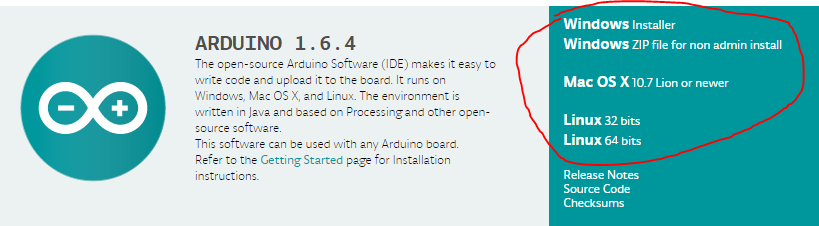
[picture p60: figure]

c. Install the IDE
d. Plug the USB cable in your Arduino as well as your computer (like connect your cell phone to the computer)
e. Open Arduino IDE by double click the icon
f. Select the board you are using

(We will use Arduino Mega 2560 for our project, but I only have Arduino Micro for this tutorial)

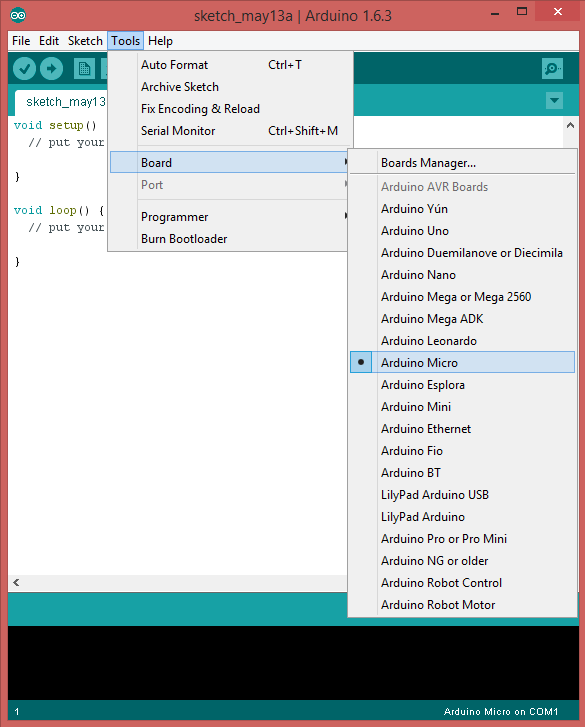
[picture p61: figure]

g. Select COM port of the Arduino

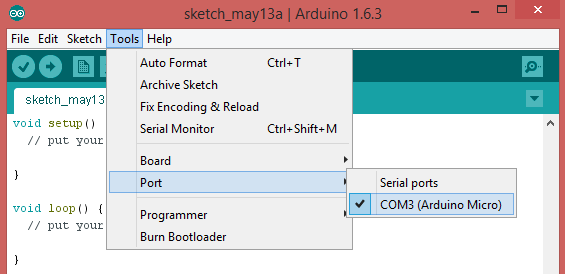
[picture p62: figure]

h. Now try to compile and burn a program into Arduino

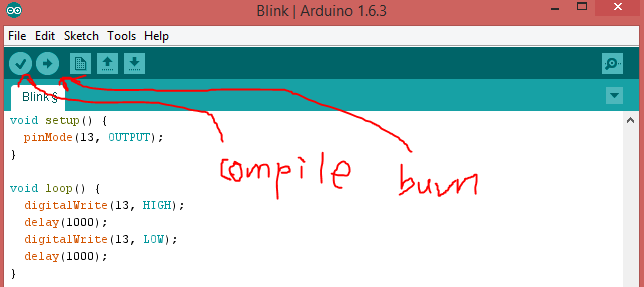
[picture p63: figure]

Click the “Compile(Verify)” button to compile the program

Click the “Burn(Upload)” button to compile and then burn the program into Arduino

After several seconds, you can see the LED on the Arduino board blinks.
