taoqiuyang/SailBoat/Mechanical Models/sail_holder_assembly.JPG

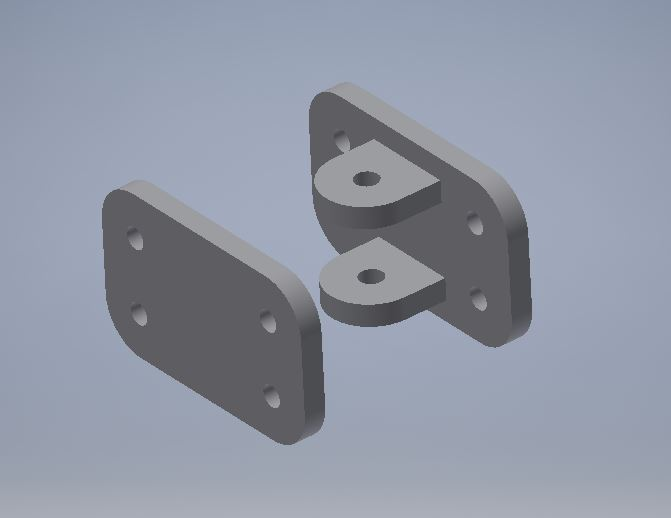
Mechanical Models/sail_holder_assembly.JPG
