taoqiuyang/SailBoat/Document/Oral Presentation/Proposal Presentation.pdf

# Autonomous SailBoat

## Unmanned Penguin Tracking System

09/03/2015

## Ci Chen Yuqing Peng Xuefeng Jin Qiuyang Tao Enmao Diao

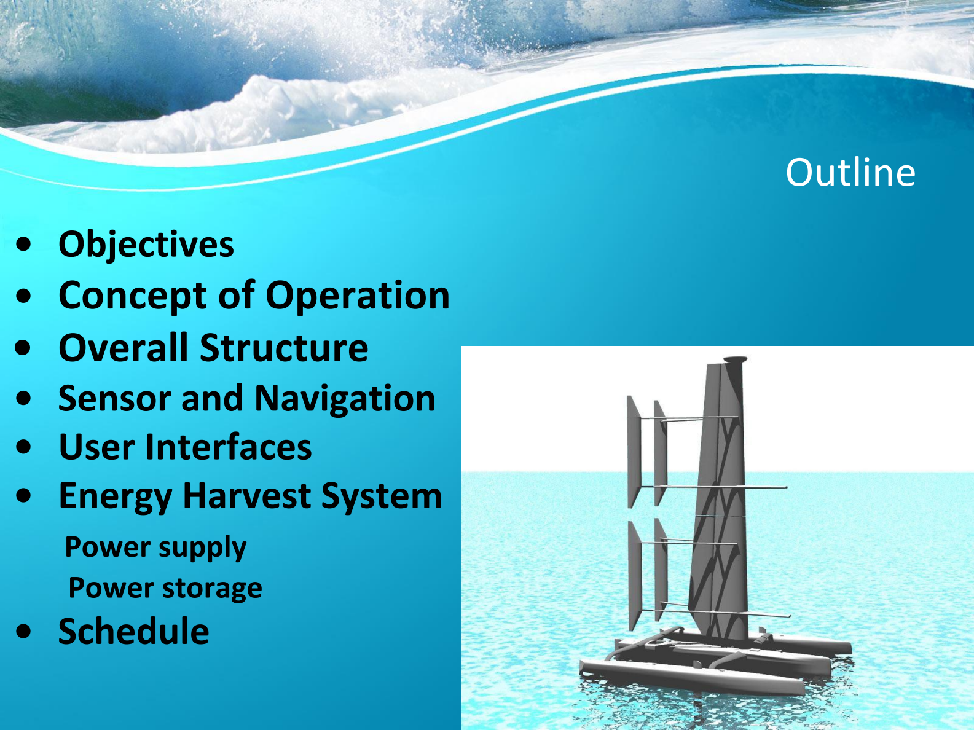
[picture p65: page 2]

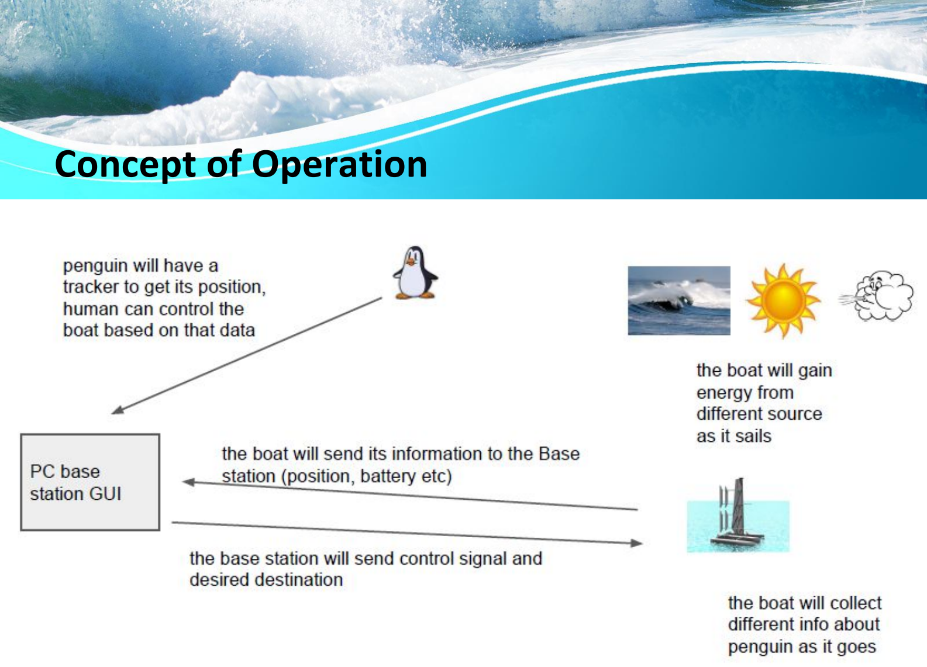
[picture p66: page 3]

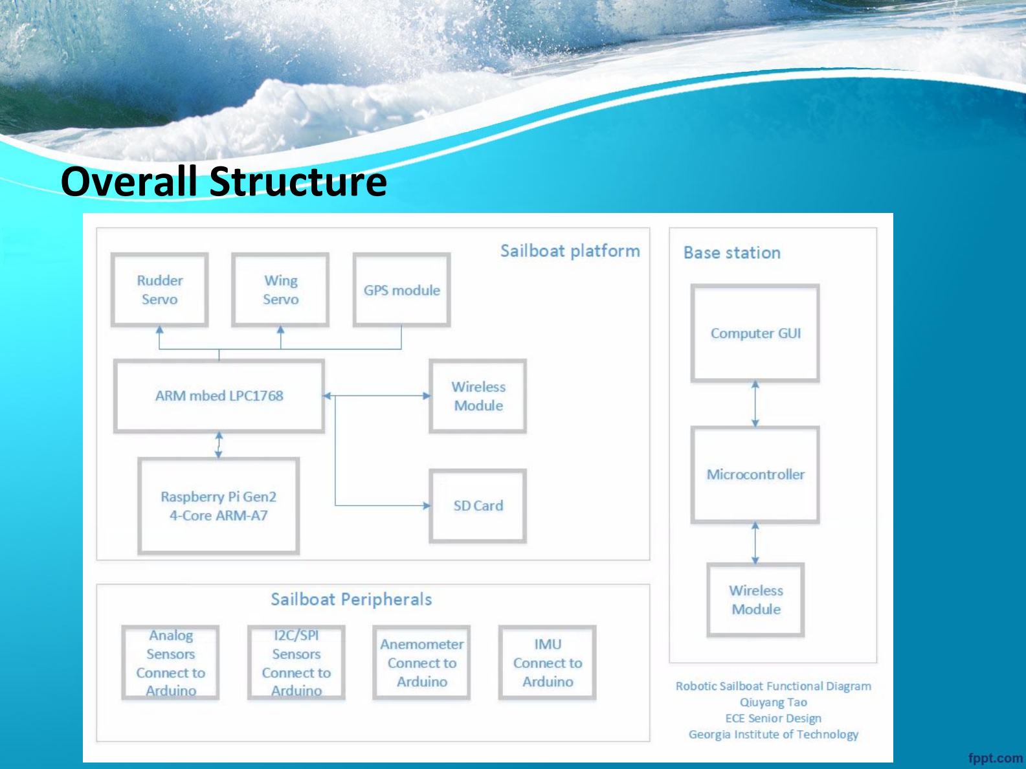
[picture p67: page 4]

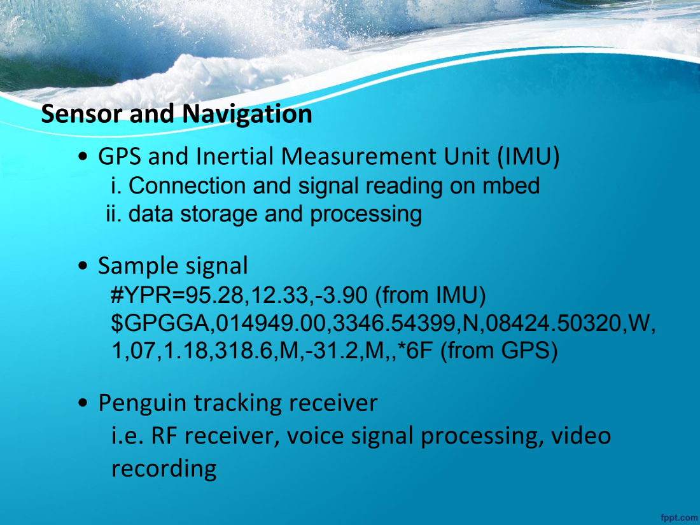
[picture p68: page 5]

i. Connection and signal reading on mbed
ii. data storage and processing

#YPR=95.28,12.33,-3.90 (from IMU)
$GPGGA,014949.00,3346.54399,N,08424.50320,W,
1,07,1.18,318.6,M,-31.2,M,,*6F (from GPS)

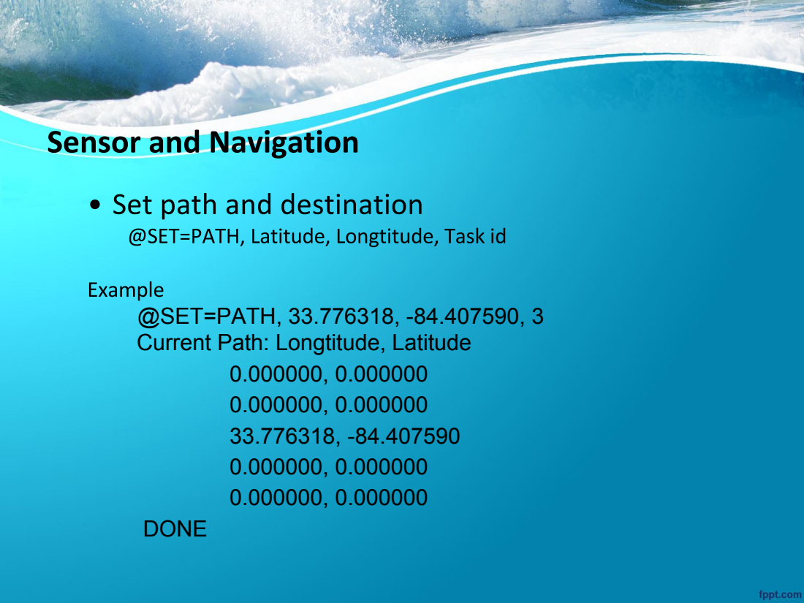
[picture p69: page 6]
DONE

@SET=PATH, 33.776318, -84.407590, 3
Current Path: Longtitude, Latitude

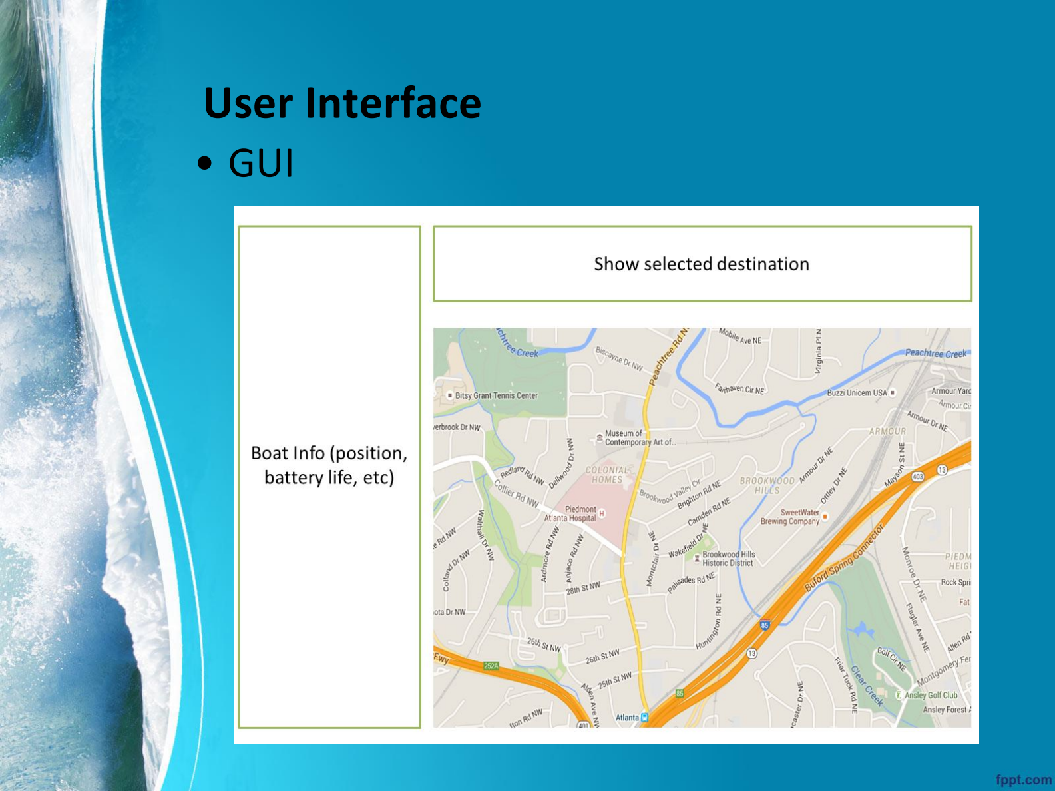
[picture p70: page 7]

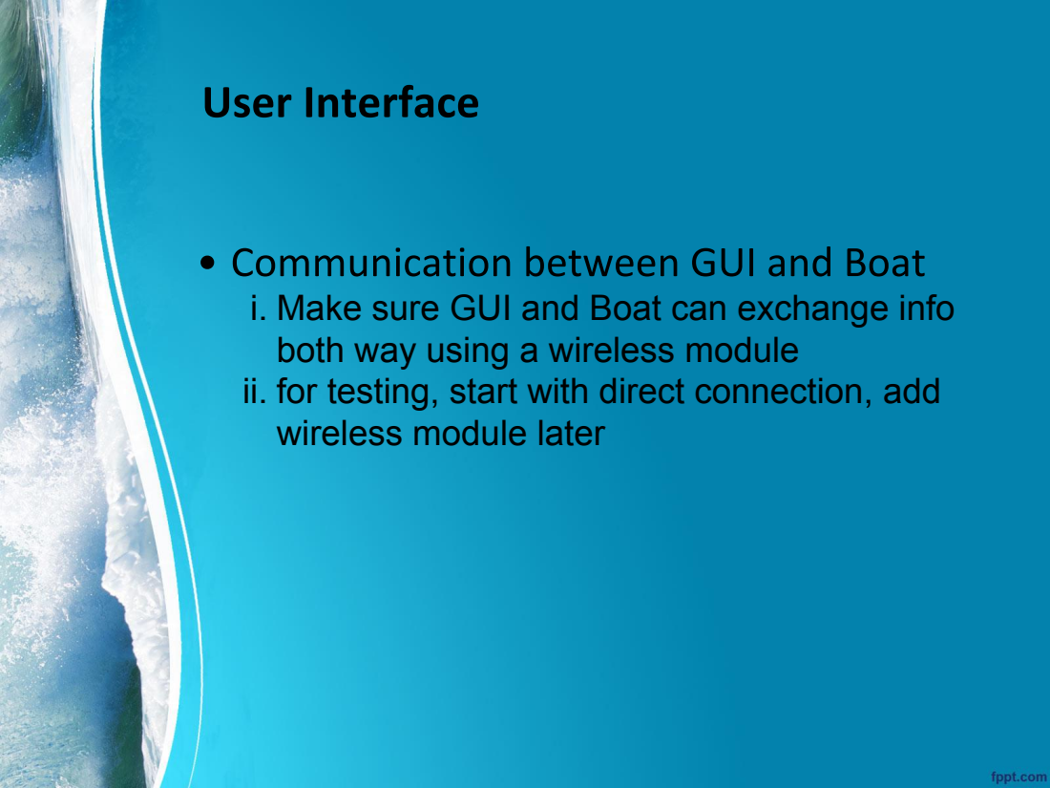
[picture p71: page 8]

i. Make sure GUI and Boat can exchange info
both way using a wireless module
ii. for testing, start with direct connection, add
wireless module later

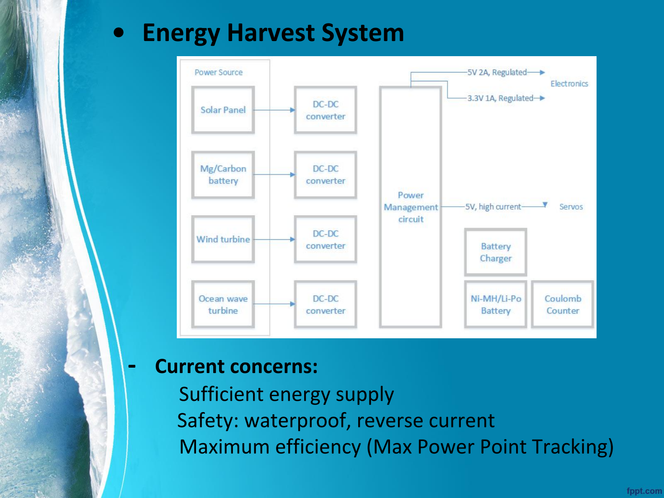
[picture p72: page 9]

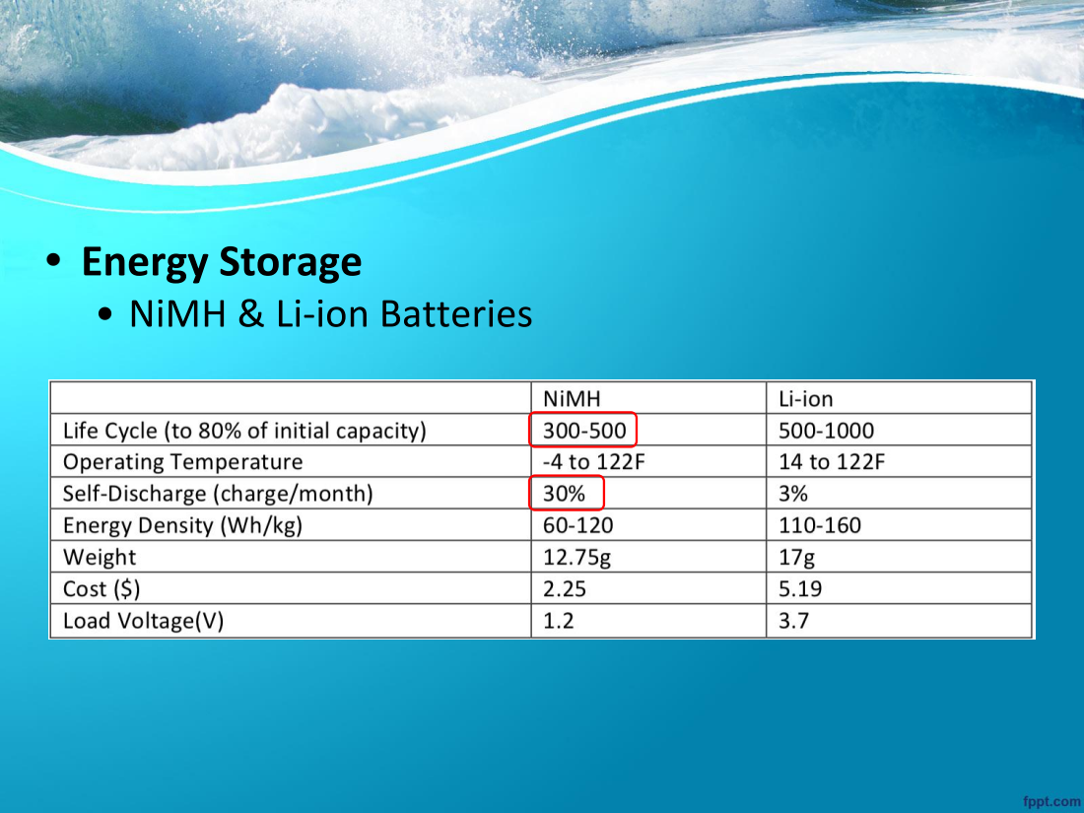
[picture p73: page 10]

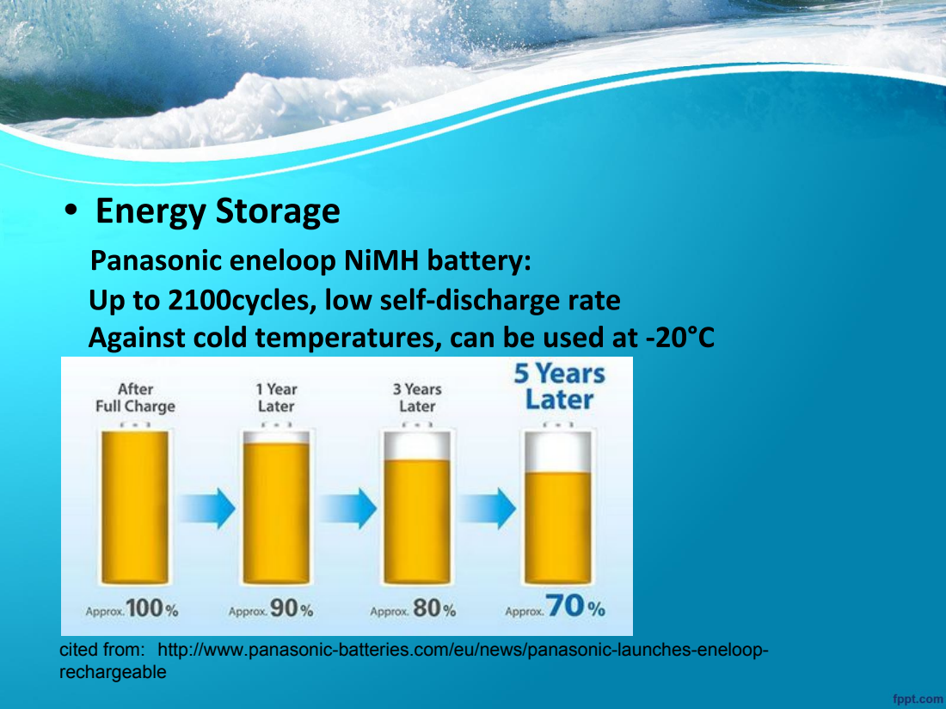
[picture p74: page 11]

cited from: http://www.panasonic-batteries.com/eu/news/panasonic-launches-eneloop-
rechargeable

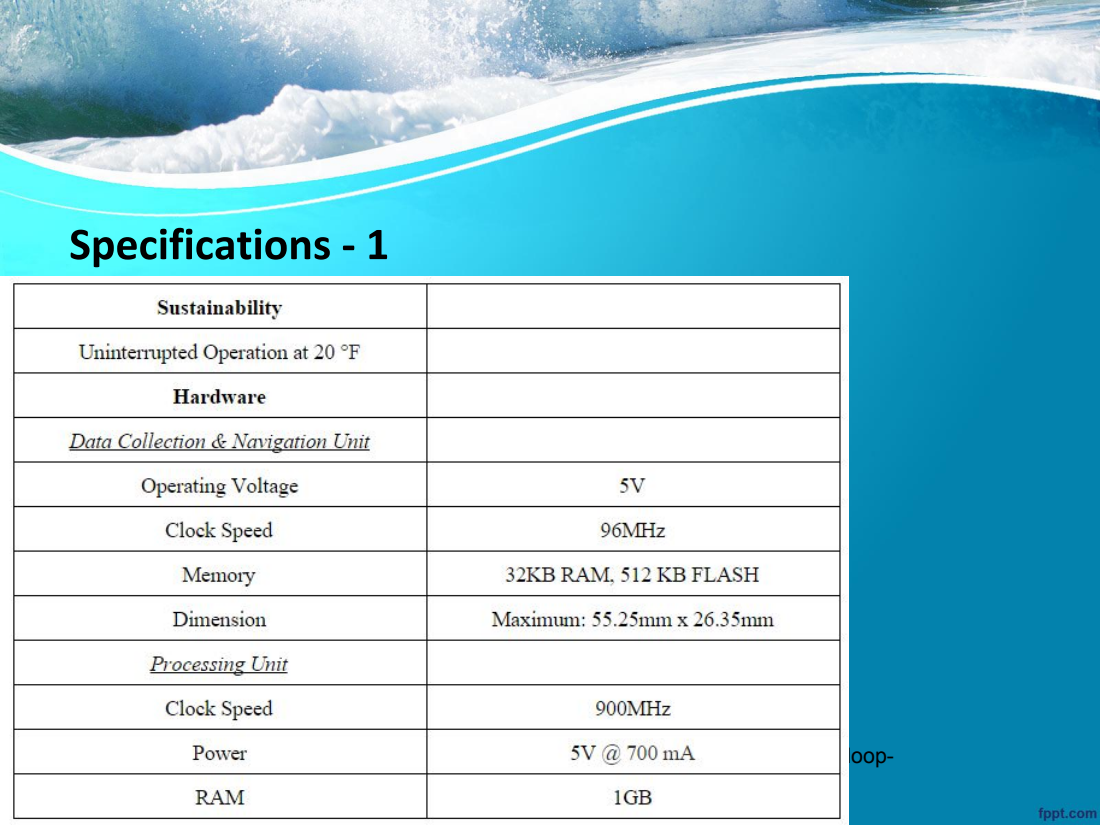
[picture p75: page 12]

cited from: http://www.panasonic-batteries.com/eu/news/panasonic-launches-eneloop-
rech

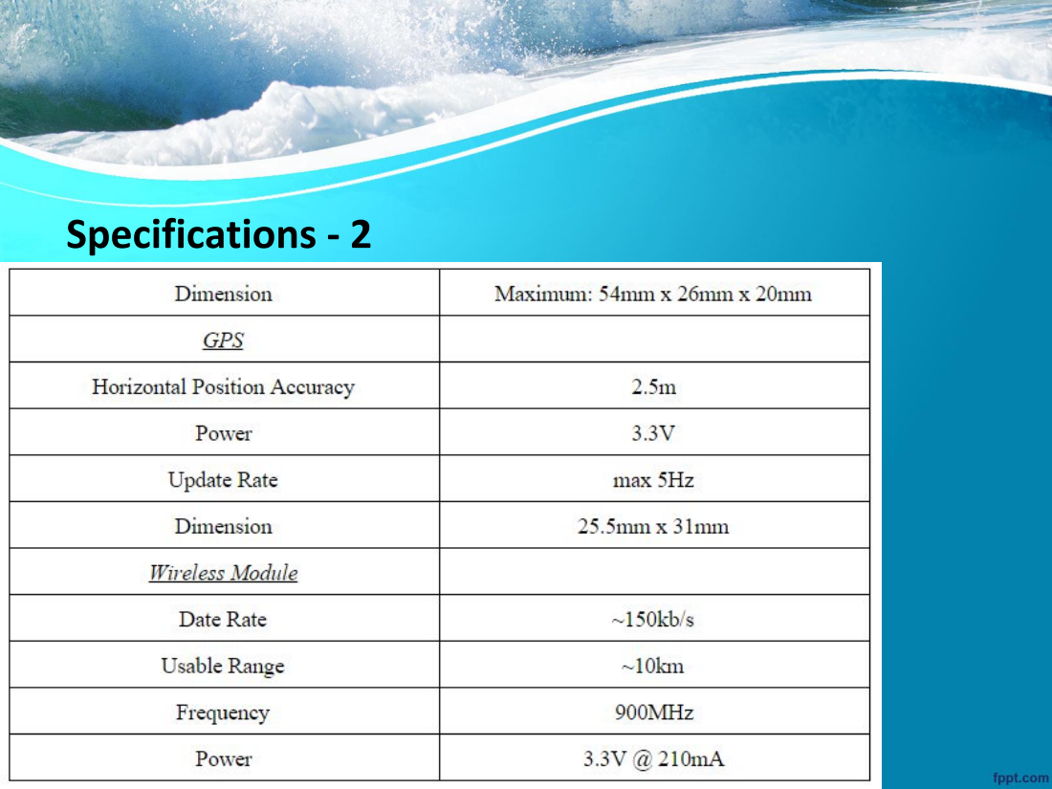
[picture p76: page 13]

cited from: http://www.panasonic-batteries.com/eu/news/panasonic-launches-eneloop-
rechargeable

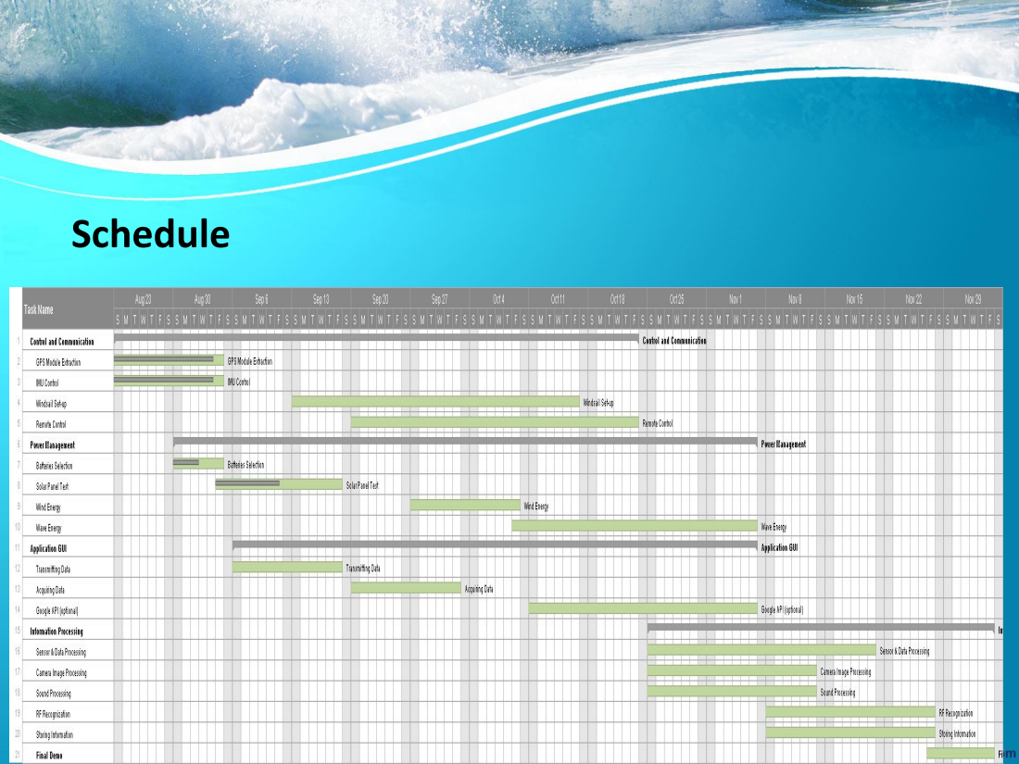
[picture p77: page 14]

cited from: http://www.panasonic-batteries.com/eu/news/panasonic-launches-eneloop-
rechargeable

# Question and Suggestions?
