taoqiuyang/SailBoat/src/mbed/ECE4012_Sailboat/mbed/TARGET_LPC1768/cmsis.h

/* mbed Microcontroller Library - CMSIS
 * Copyright (C) 2009-2011 ARM Limited. All rights reserved.
 * 
 * A generic CMSIS include header, pulling in LPC1768 specifics
 */

#ifndef MBED_CMSIS_H
#define MBED_CMSIS_H

#include "LPC17xx.h"
#include "cmsis_nvic.h"

#endif
