taoqiuyang/SailBoat/src/mbed/ECE4012_Sailboat/mbed/TARGET_LPC1768/system_LPC17xx.h

/******************************************************************************
 * @file:    system_LPC17xx.h
 * @purpose: CMSIS Cortex-M3 Device Peripheral Access Layer Header File
 *           for the NXP LPC17xx Device Series 
 * @version: V1.02
 * @date:    27. July 2009
 *----------------------------------------------------------------------------
 *
 * Copyright (C) 2009 ARM Limited. All rights reserved.
 *
 * ARM Limited (ARM) is supplying this software for use with Cortex-M3 
 * processor based microcontrollers.  This file can be freely distributed 
 * within development tools that are supporting such ARM based processors. 
 *
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
 ******************************************************************************/


#ifndef __SYSTEM_LPC17xx_H
#define __SYSTEM_LPC17xx_H

#ifdef __cplusplus
 extern "C" {
#endif 

extern uint32_t SystemCoreClock;     /*!< System Clock Frequency (Core Clock)  */


/**
 * Initialize the system
 *
 * @param  none
 * @return none
 *
 * @brief  Setup the microcontroller system.
 *         Initialize the System and update the SystemCoreClock variable.
 */
extern void SystemInit (void);

/**
 * Update SystemCoreClock variable
 *
 * @param  none
 * @return none
 *
 * @brief  Updates the SystemCoreClock with current core Clock 
 *         retrieved from cpu registers.
 */
extern void SystemCoreClockUpdate (void);

#ifdef __cplusplus
}
#endif

#endif /* __SYSTEM_LPC17xx_H */
