taoqiuyang/SailBoat/(commit log)

2015-05-13 Arduino Tutorial
2015-08-06 IMU documents
2015-08-14 Test mbed's serial port
    Use Sreial Interrupt and read messages(strings) from the IMU or GPS
2015-08-24 IMU signal processing finished
2015-08-26 IMU and GPS done, need to pack strings and computer command not done
2015-08-26 Hardware connection
    pin connections
2015-08-29 Servo added by Qiuyang and tested
2015-10-13 website update, wireless config
2015-10-24 servo angle set added
2015-10-29 php failed, switch to python, python and mbed communication complete
    [Config.h, Set.cpp, main.cpp, port.py]
2015-10-29 add code for python gui, please tell me what could be the cause of the bug
    [port.py]
2015-11-01 Mechanical parts
    [carbon_fiber.ipt, rudder_hold.ipt, sail_hold_1.dwg, sail_hold_1.ipt, sail_hold_1.stl, sail_hold_2.dwg, sail_hold_2.ipt, sail_hold_2.stl]
2015-11-04 3D part for rudder
    [rudder_hold_1.0001.ipt, rudder_hold_1.ipt, rudder_hold_1.stl]
2015-11-19 remove a bug, add showing gps info
    [qt_gui.py]
